Tuetuopay/dalton-evse/README.md

# OSS EVSE

I hope you like the daltons!
