Tuetuopay/dalton-evse/averell4evse/README.md

# averell4evse

The largest PCB housing the input devices (NFC, touch).
