Tuetuopay/dalton-evse/joe4evse/README.md

# joe4evse

Joe, the brain of the operation. Main PCB of Daltons EVSE
