Tuetuopay/dalton-evse/ma4evse/README.md

# ma4evse

KiCAD components symbol, footprints and 3D models for Dalton PCBs
