Tuetuopay/dalton-evse/joe4evse/FIPYPinout.ods

Sheet: Pinout
FIPY Pinout
Pin Name | GPIO Name | Pin Type | Specificity | Function
P0 | GPIO3 | IO | PROG | PROG
P1 | GPIO1 | IO | PROG | PROG
P2 | GPIO0 | IO
P3 | GPIO4 | IO |  | MODBUS SMART METER | UART TX EVSE
P4 | GPIO15 | IO |  | MODBUS SMART METER | UART RX EVSE
(LORA)CLK | GPIO5 | IO |  | CLK Averell
(LORA)MOSI | GPIO27 | IO |  | MOSI Averell
(LORA)MISO | GPIO19 | IO |  | MISO Averell
P8 | GPIO2 | IO |  | nRST NFC
P9 | GPIO12 | IO |  | IRQ NFC
P10 | GPIO13 | IO |  | nRSTOUT NFC
P11 | GPIO22 | IO |  | SS NFC
P12 | GPIO21 | IO | ANT Switch
P13 | GPIO36 | I |  | SS LED
P14 | GPIO37 | I
LTE_WAKE | GPIO38 | I
P16 | GPIO39 | I
LTE_CTS | GPIO35 | I
LTE_RX | GPIO34 | I
LTE_RTS | GPIO23 | IO
LTE_TX | GPIO33 | IO
P21 | GPIO26 | IO
P22 | GPIO25 | IO |  | MOD_EN
P23 | GPIO14 | IO |  | RELAY (Outlet Lock)

Sheet: Revision History
Version | Date | Description
2.1 | 6/13/2013 | Included package ordering code.
2.0 | 3/13/2013 | Updated table format to include all packages
1.0 | 10/1/2012 | Chnaged name from "TQ144" to "144-pin TQFP" Production Release
0.92 | 12/14/2011 | Package drawing, removed option notes 6 and 7
0.91 | 11/13/2011 | 1K pins 40, 49, 50, 52, 133, 134 updated
0.9 | 10/31/2011 | Preliminary
