Tuetuopay/dalton-evse/ma4evse/3d/ASMB-MTB0-0A3A2.step

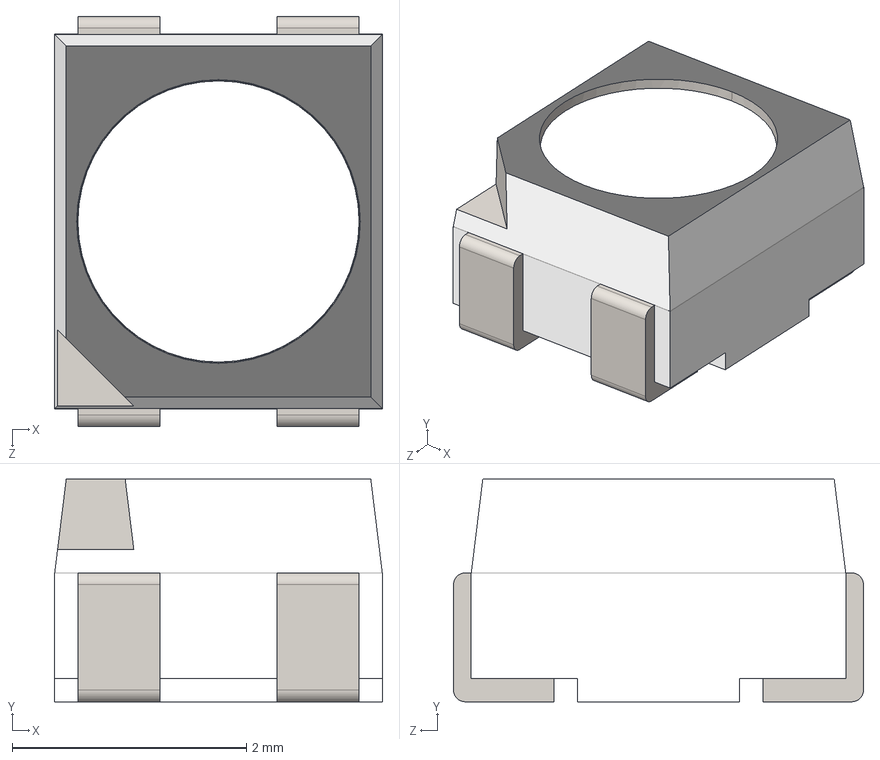
[picture p1: CAD file, 2022-01-18]
ma4evse/3d/ASMB-MTB0-0A3A2.step
2.80 x 1.90 x 3.50 mm
