Tuetuopay/dalton-evse/jack4evse/jack.FCStd

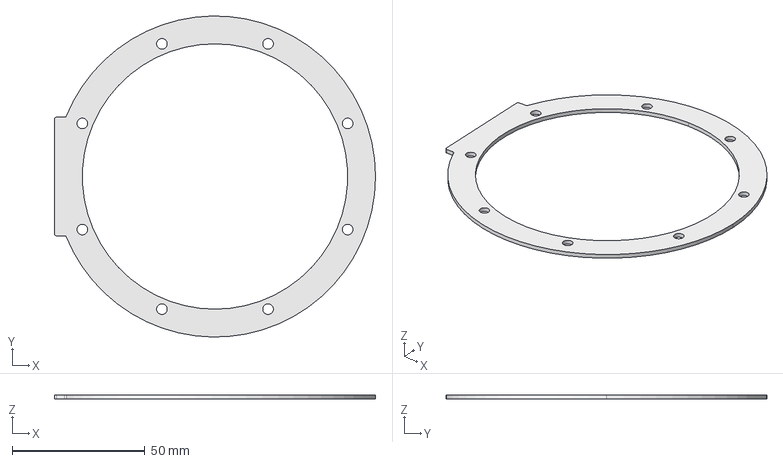
[picture p2: CAD file, 2022-01-18]
jack4evse/jack.FCStd
121.0 x 121.0 x 1.60 mm
