Tuetuopay/dalton-evse/william4evse/RCMB121.FCStd

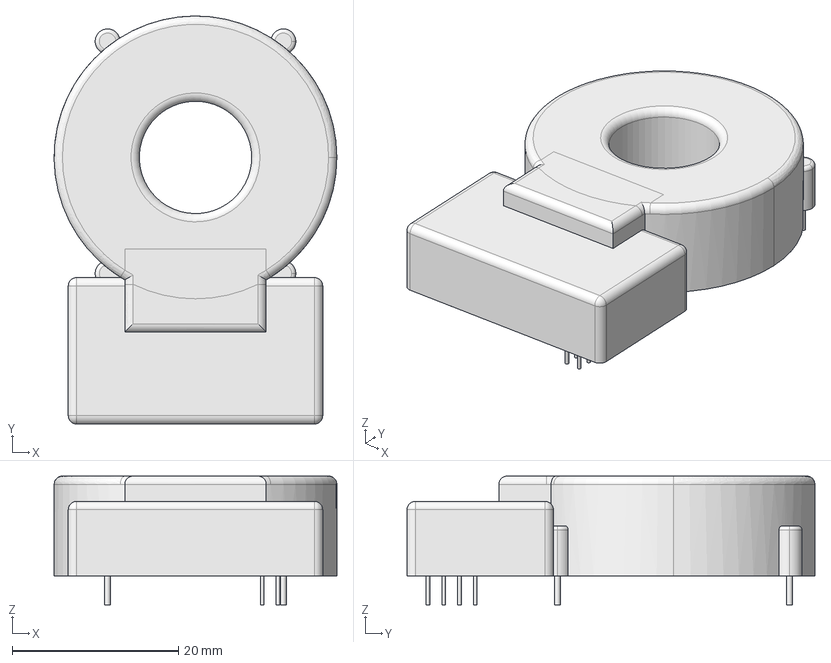
[picture p3: CAD file, 2022-01-18]
william4evse/RCMB121.FCStd
34.0 x 49.0 x 15.5 mm
