Tuetuopay/dalton-evse/ma4evse/3d/Wurth_614105150721.step

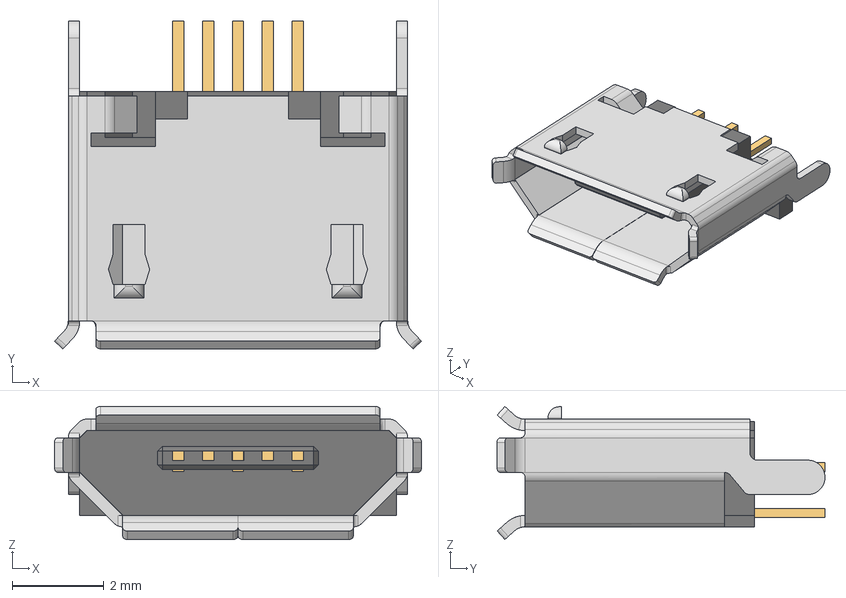
[picture p4: CAD file, 2022-01-18]
ma4evse/3d/Wurth_614105150721.step
8.00 x 7.15 x 2.90 mm
614105150721_Housing
614105150721_Pin1 x 3
614105150721_Pin2 x 2
614105150721_Shielding
