Tuetuopay/dalton-evse/ma4evse/3d/JIS C 6560.step

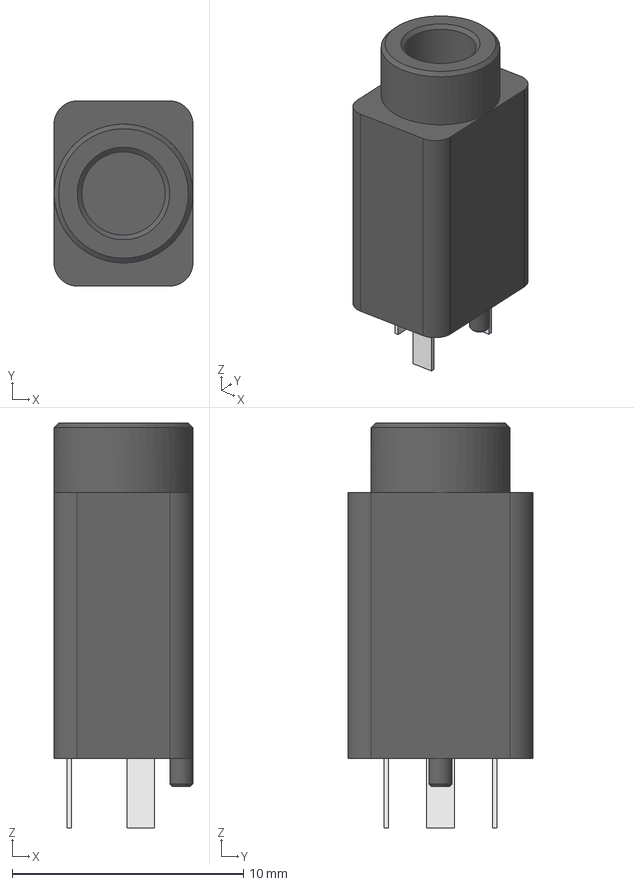
[picture p5: CAD file, 2022-01-18]
ma4evse/3d/JIS C 6560.step
6.00 x 8.00 x 17.5 mm
Pins
