Tuetuopay/dalton-evse/ma4evse/3d/PJ-307C.step

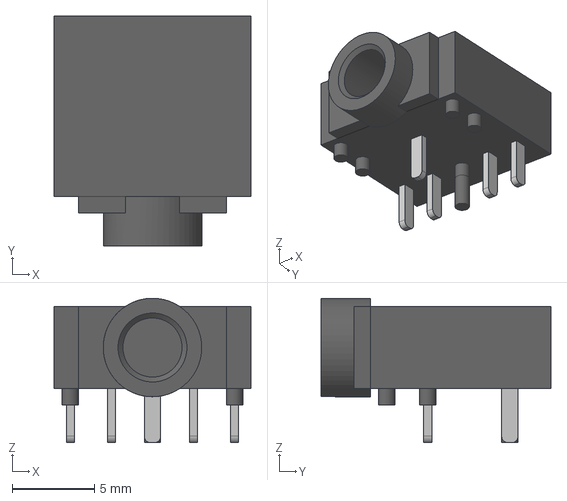
[picture p6: CAD file, 2022-01-18]
ma4evse/3d/PJ-307C.step
12.0 x 14.0 x 8.80 mm
Pins
