Tuetuopay/dalton-evse/ma4evse/3d/HLK-PM0x.step

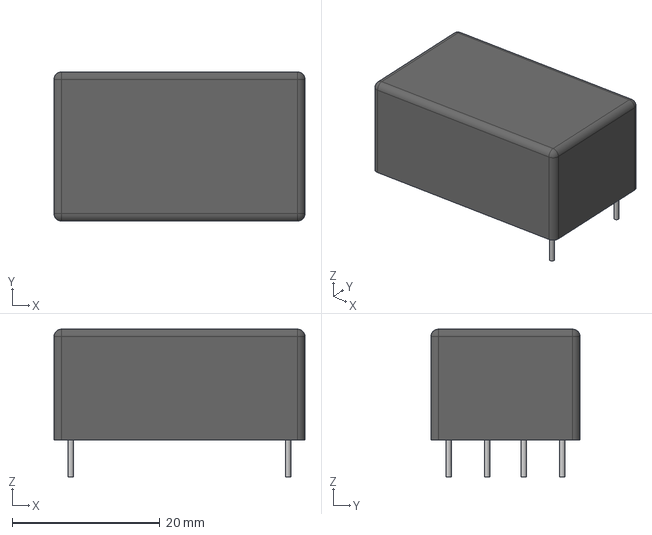
[picture p7: CAD file, 2022-01-18]
ma4evse/3d/HLK-PM0x.step
34.0 x 20.2 x 20.0 mm
Pins
