Tuetuopay/dalton-evse/ma4evse/3d/LoPy v1.stp

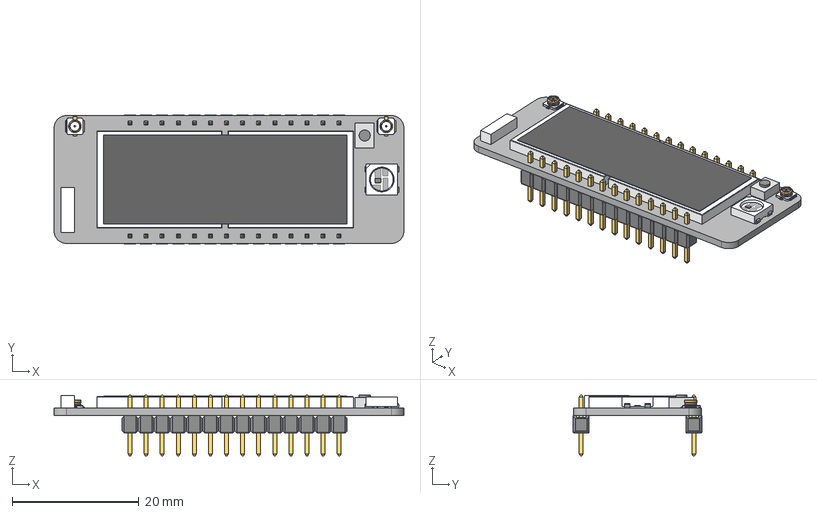
[picture p8: CAD file, 2022-01-18]
ma4evse/3d/LoPy v1.stp
55.2 x 20.3 x 9.60 mm
PCB
Mold x 2
Antenna
Button
ButtonTop
Label
