Tuetuopay/dalton-evse/ma4evse/3d/2520 SMD Crystal Oscillator.STEP

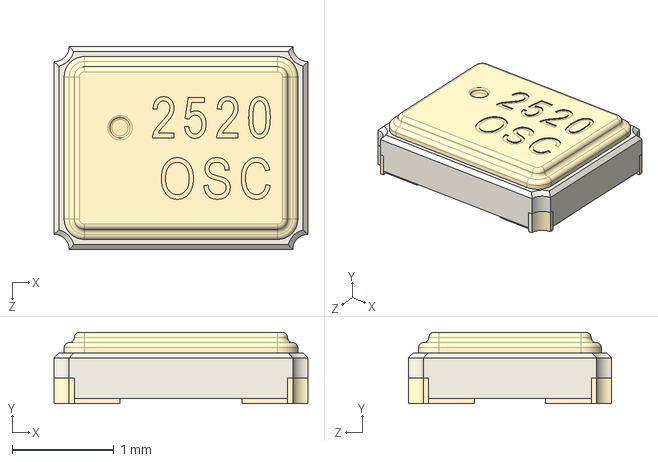
[picture p9: CAD file, 2022-01-18]
ma4evse/3d/2520 SMD Crystal Oscillator.STEP
2.50 x 0.7 x 2.00 mm
