Tuetuopay/dalton-evse/ma4evse/3d/pxc_2896416_01_BC-53-6-OT-U11-KMGY_3D.stp

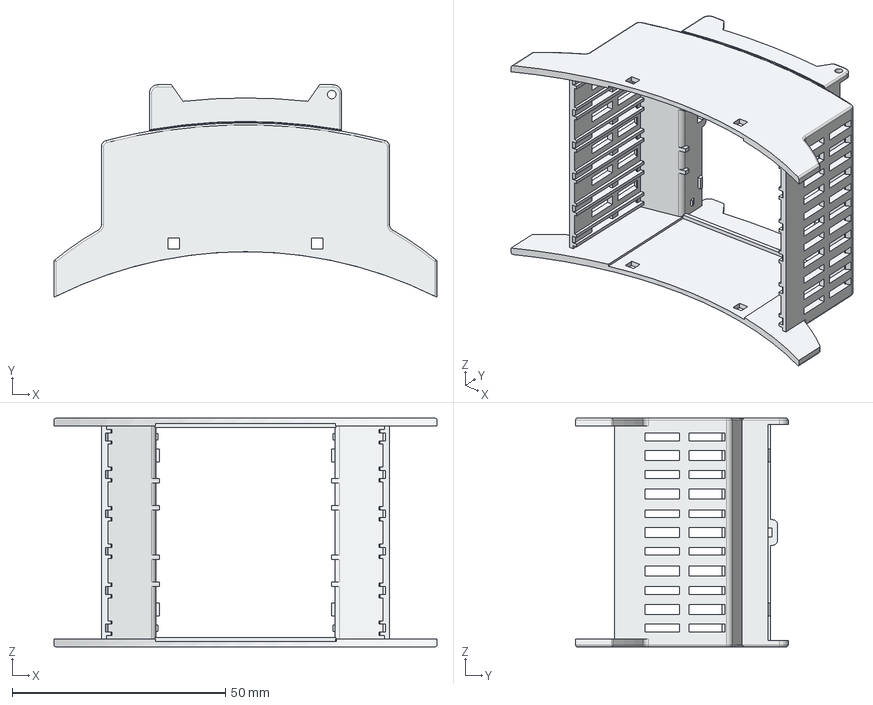
[picture p10: CAD file, 2022-01-18]
ma4evse/3d/pxc_2896416_01_BC-53-6-OT-U11-KMGY_3D.stp
89.7 x 49.8 x 53.6 mm
