Tuetuopay/dalton-evse/ma4evse/3d/pxc_2896403_03_BC-53-6-UT-HBUS-BK_3D.stp

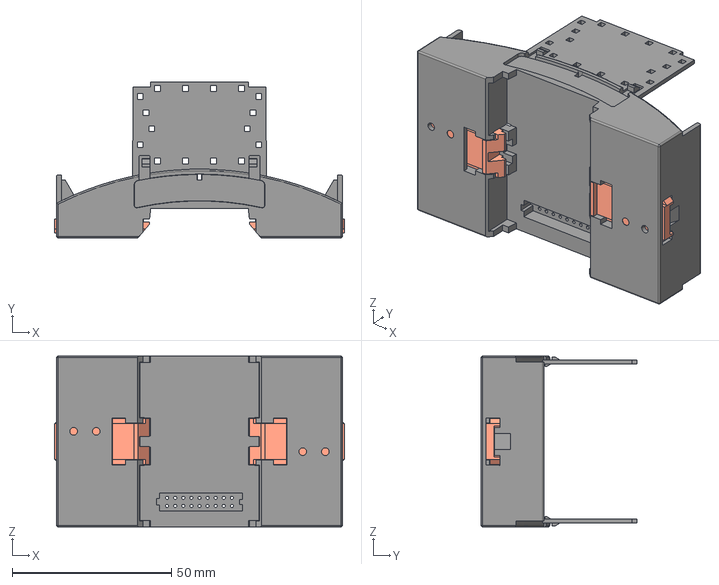
[picture p11: CAD file, 2022-01-18]
ma4evse/3d/pxc_2896403_03_BC-53-6-UT-HBUS-BK_3D.stp
91.0 x 48.9 x 53.6 mm
BC_53_6_GEH-UT_HBUS_H.Select__00383604
Fussriegel_14.4_L30_Sperr_H.Select__00370451 x 2
