Tuetuopay/dalton-evse/ma4evse/3d/FTSH-108-01-F-D-RA.stp

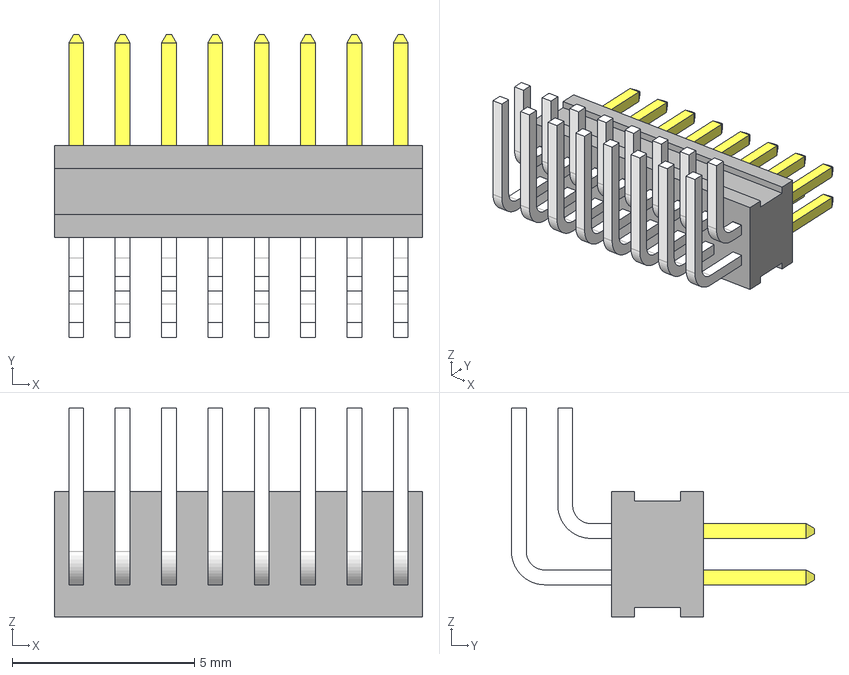
[picture p12: CAD file, 2022-01-18]
ma4evse/3d/FTSH-108-01-F-D-RA.stp
10.1 x 8.31 x 5.72 mm
_FTSH-108-01-F-D-RA_body
_FTSH-108-01-F-D-RA_pins1
_FTSH-108-01-F-D-RA_pins2
