Tuetuopay/dalton-evse/ma4evse/3d/CLP-108-02-F-DH.stp

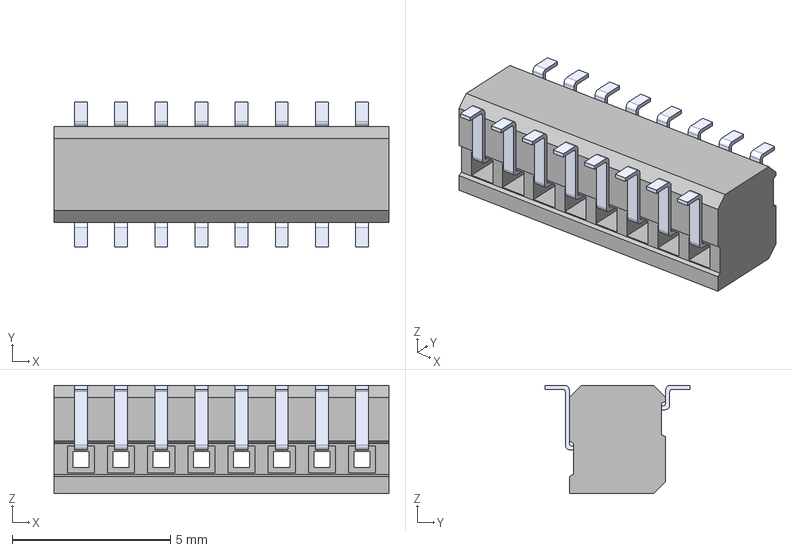
[picture p13: CAD file, 2022-01-18]
ma4evse/3d/CLP-108-02-F-DH.stp
10.6 x 4.57 x 3.43 mm
_CLP-108-2-F-DH_terminal
_C-70-04-108_Pin_2_dh
_C-70-05-108_Pin_dh
