Tuetuopay/dalton-evse/ma4evse/3d/nfc_v4.step

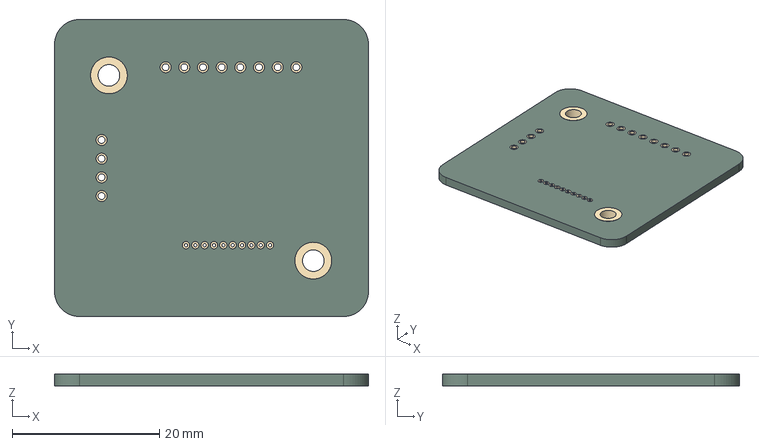
[picture p14: CAD file, 2022-01-18]
ma4evse/3d/nfc_v4.step
42.7 x 40.4 x 1.66 mm
Pcb
Pcb001
