Tuetuopay/dalton-evse/ma4evse/3d/Screw Terminal Block 3.5mm 2-way.step

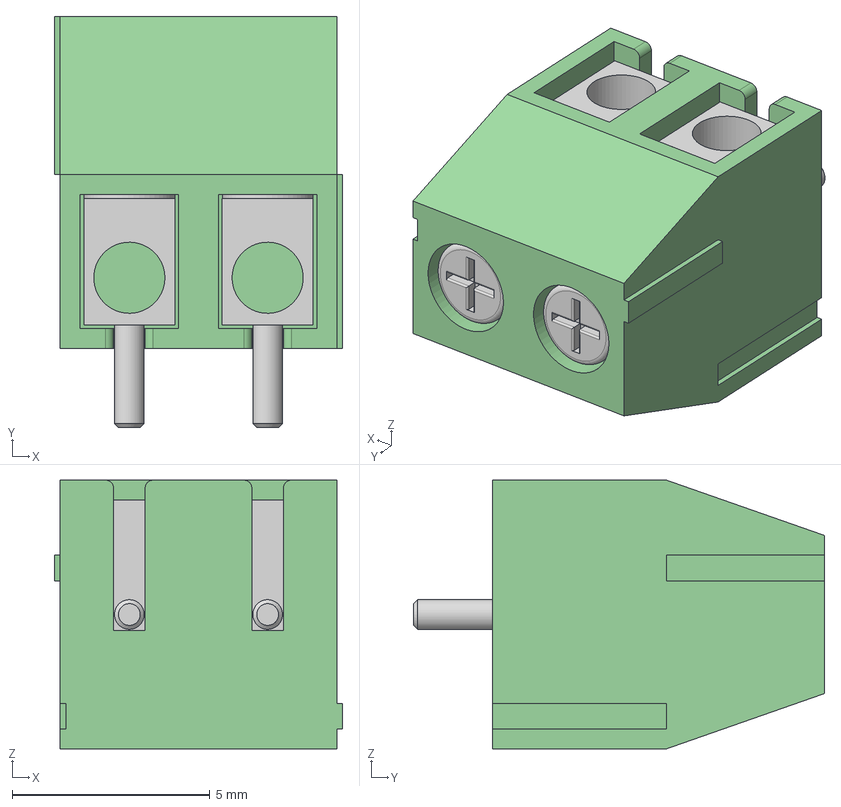
[picture p15: CAD file, 2022-01-18]
ma4evse/3d/Screw Terminal Block 3.5mm 2-way.step
7.30 x 10.4 x 6.80 mm
