Tuetuopay/dalton-evse/ma4evse/3d/ScrewTerminal.STEP

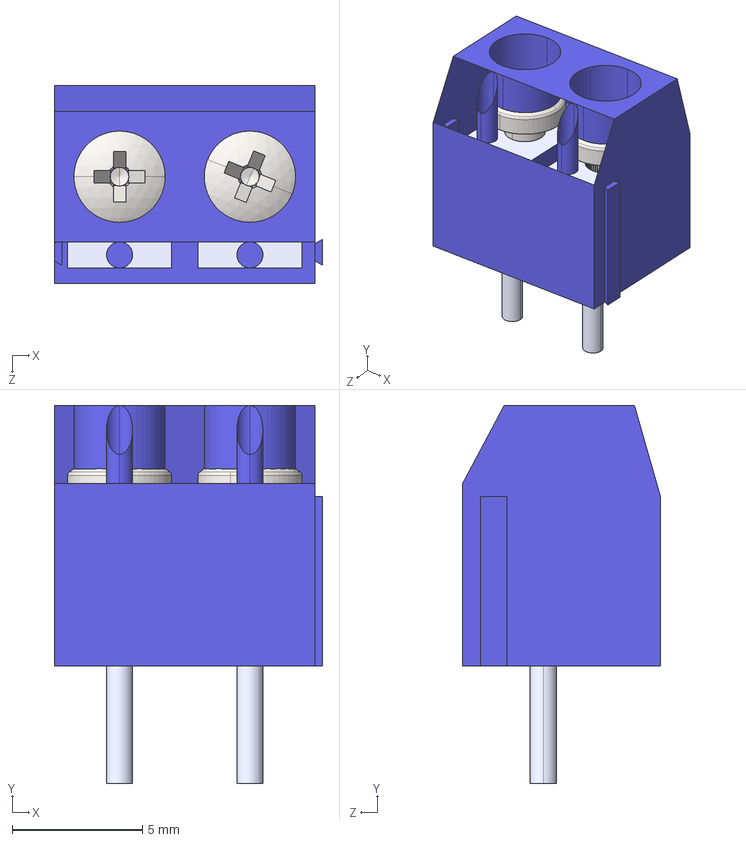
[picture p16: CAD file, 2022-01-18]
ma4evse/3d/ScrewTerminal.STEP
10.3 x 14.5 x 7.60 mm
ScrewTerminalCover
Pin x 2
pan head cross recess screw_iso_ISO 7045 - M2 x 3 - Z - 3N x 2
