Tuetuopay/dalton-evse/ma4evse/3d/JS202011CQN.stp

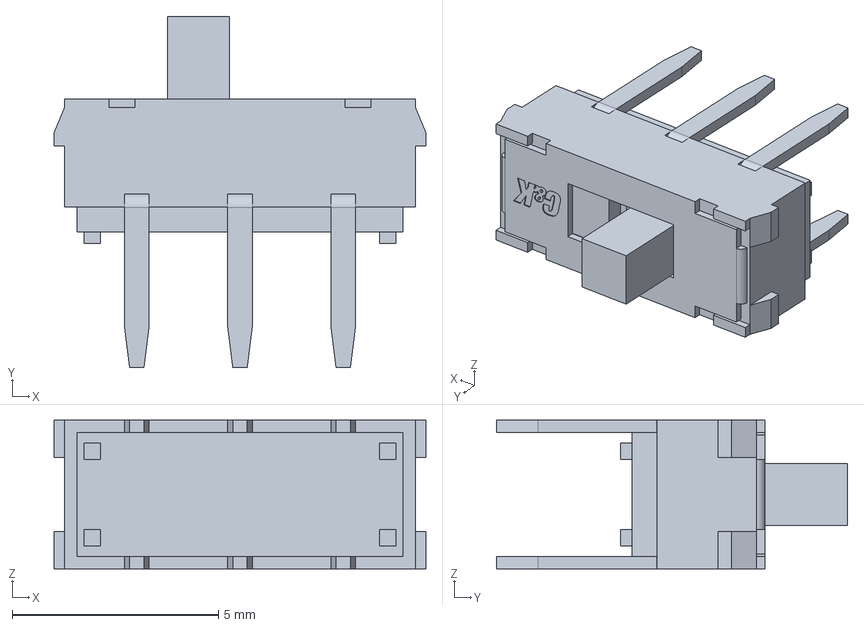
[picture p17: CAD file, 2022-01-18]
ma4evse/3d/JS202011CQN.stp
9.00 x 8.50 x 3.60 mm
