Tuetuopay/dalton-evse/(list of files, cad)

Other CAD files:
ma4evse/3d/RCMB121.step
jack4evse/jack.dxf
ma4evse/3d/HLK-PM0x.FCStd
ma4evse/3d/JIS C 6560.FCStd
ma4evse/3d/PJ-307C.FCStd
ma4evse/3d/nfc_v4.FCStd
william4evse/RCMB121.dxf
