Tuetuopay/dalton-evse/william4evse/william4evse.kicad_pcb

## KiCad design william4evse/william4evse.kicad_pcb (2022-01-18)

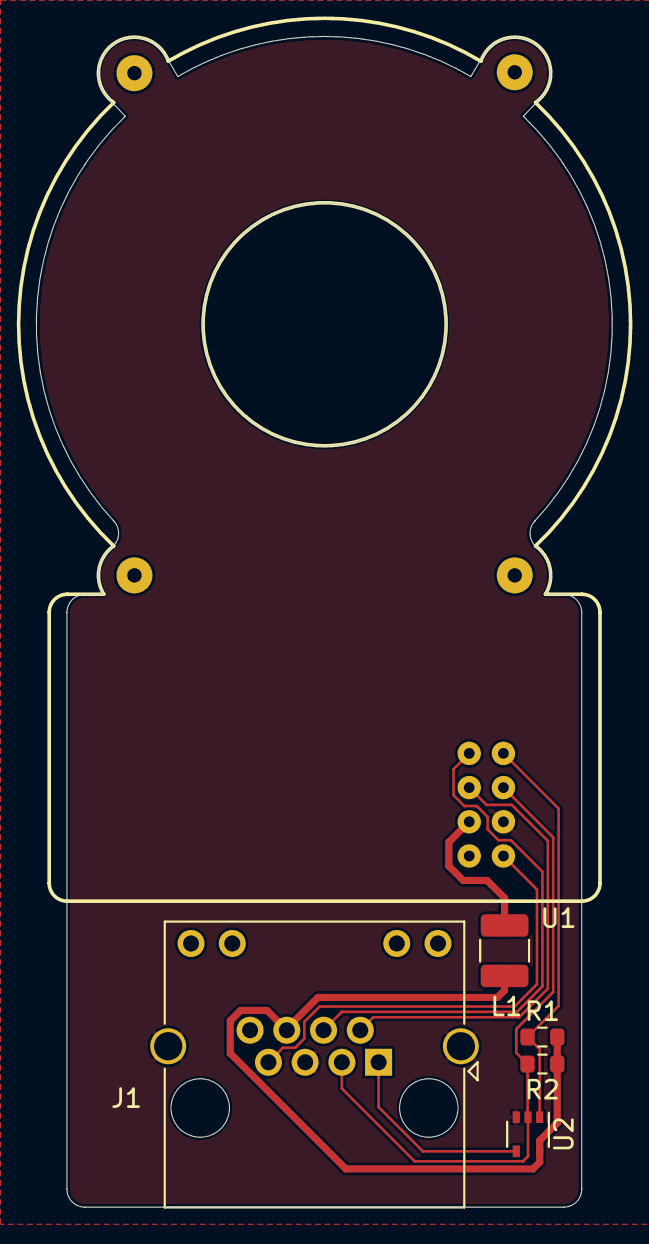
[picture p18: board william4evse.kicad_pcb from above]

Board: 2 copper layers, 32.0 x 65.0 mm, 6 parts (0 on the bottom side), 9 nets.

Parts:
J1: Boom_Precision_RJ45-B-1x1; RJ45_Amphenol_RJHSE538X
L1: 330u; L_1210_3225Metric
R1, R2: 10k; R_0603_1608Metric
U1: RCMB121
U2: 74LVC1G32; SOT-353_SC-70-5

Connections:
+5V: J1.6, L1.1, R1.2, R2.1, U2.5
/ERROR_OUT: R1.1, U1.1, U2.1
/FAULT_OUT: J1.1, U2.4
/PWM_OUT: J1.7, U1.7
/TEST_IN: J1.4, U1.2
/X6_OUT: J1.3, R2.2, U1.3, U2.2
/X30_OUT: J1.2, U1.4
GND: J1.5, J1.SH, U1.5, U2.3
unnamed: L1.2, U1.6
