Tuetuopay/dalton-evse/joe4evse/joe4evse.kicad_pcb

## KiCad design joe4evse/joe4evse.kicad_pcb (2022-01-18)

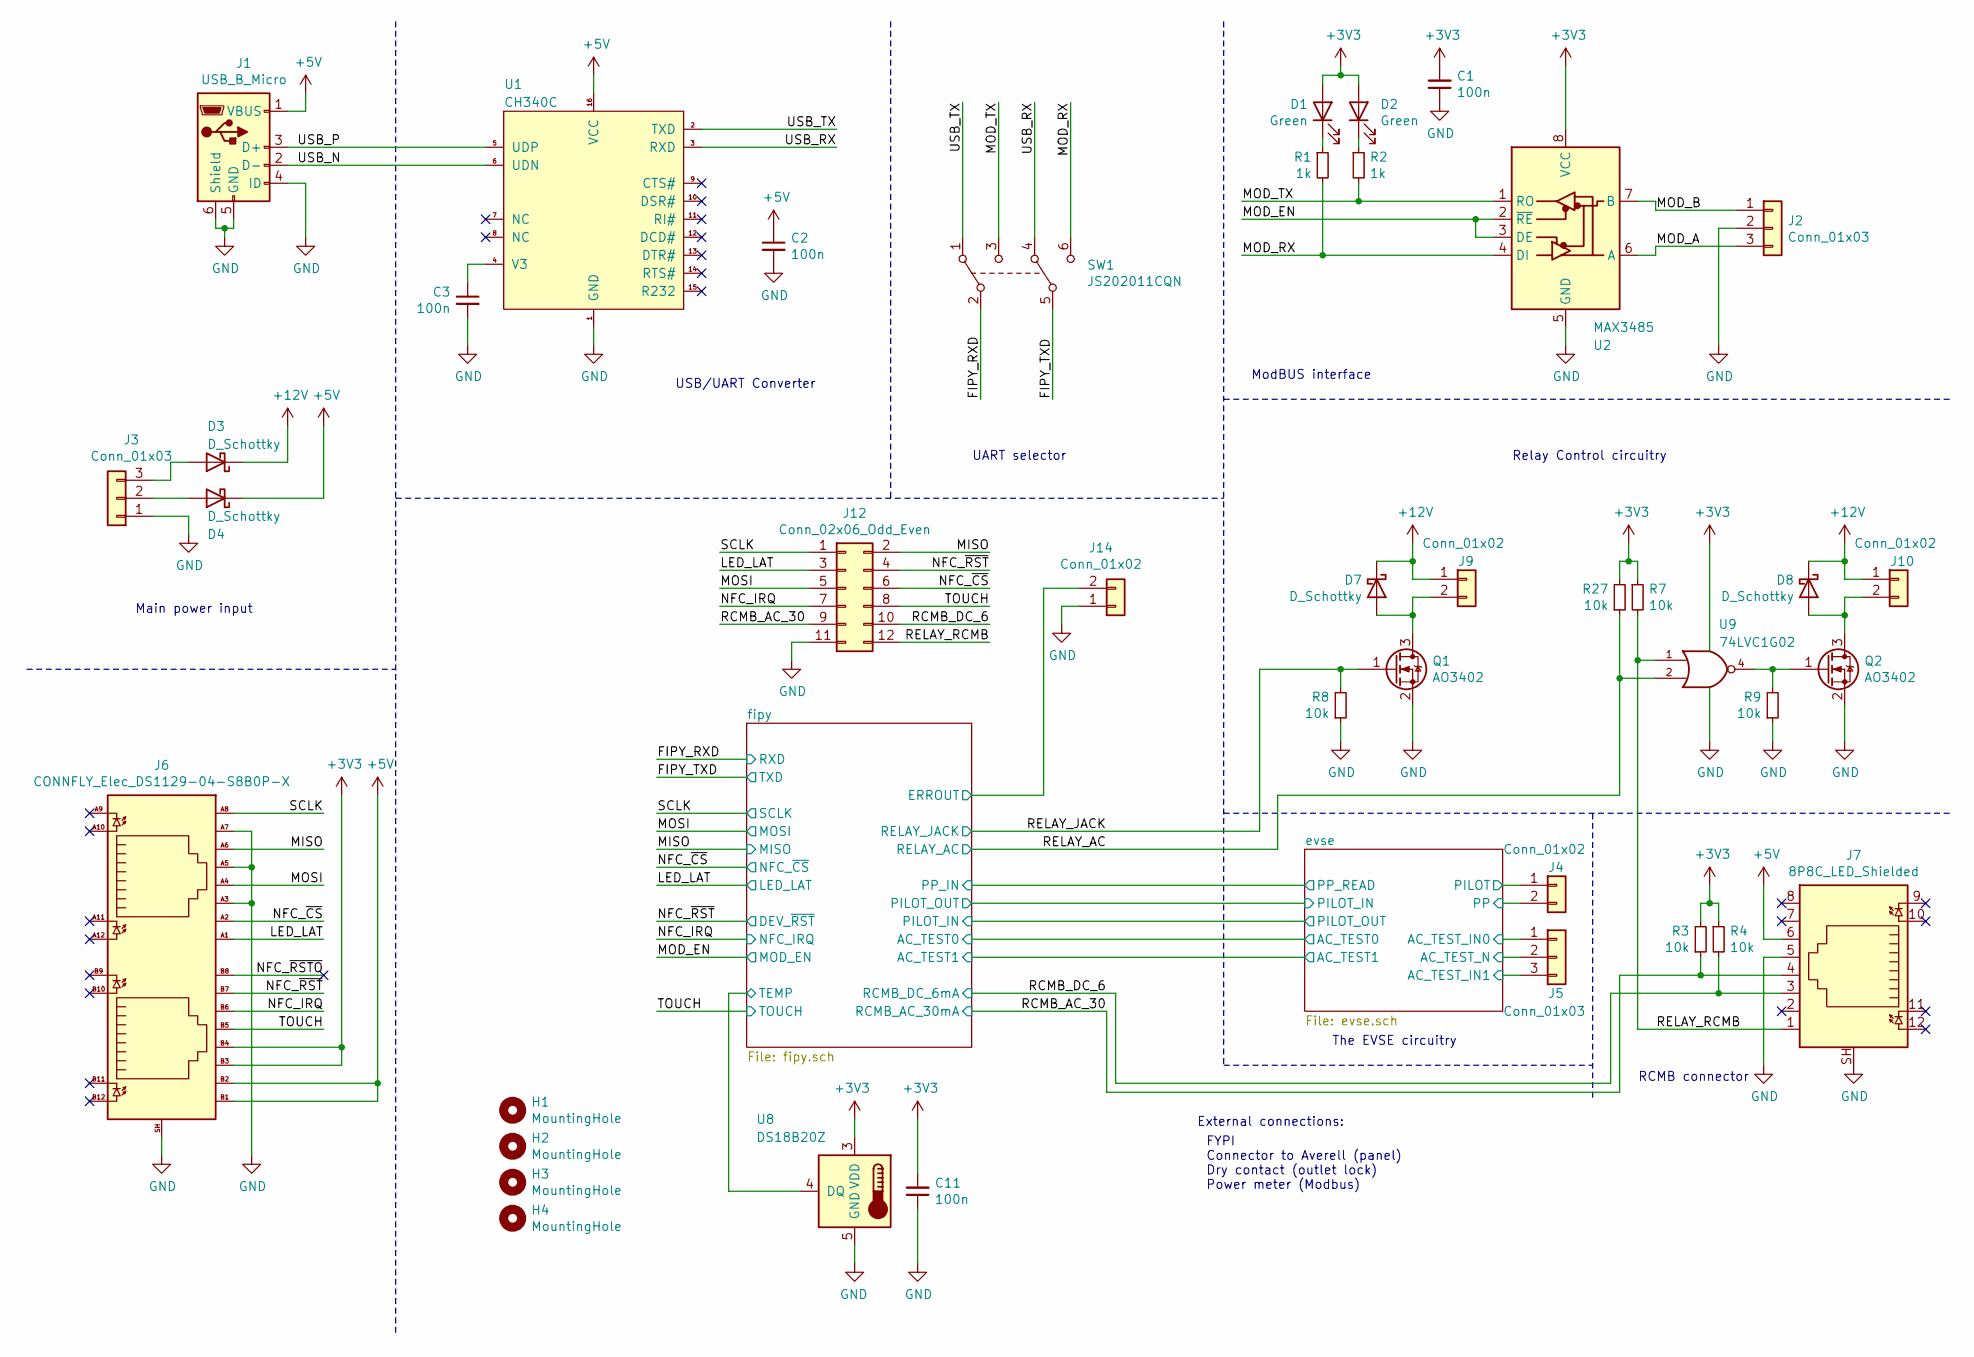
[picture p19: schematic joe4evse.sch, Joe 4 EVSE]

Parts:
C1, C2, C3, C11: 100n; C_0603_1608Metric
D1, D2: Green; LED_0603_1608Metric
D3, D4, D7, D8: D_Schottky; D_SOD-123
H1, H2, H3, H4: MountingHole; MountingHole_3.2mm_M3_Pad_Via
J1: USB_B_Micro; USB_Micro-B_Molex_47346-0001
J2: Conn_01x03; JST_PH_B3B-PH-K_1x03_P2.00mm_Vertical
J3: Conn_01x03; JST_EH_B3B-EH-A_1x03_P2.50mm_Vertical
J4, J9, J10, J14: Conn_01x02; JST_PH_B2B-PH-K_1x02_P2.00mm_Vertical
J5: Conn_01x03; JST_NV_B03P-NV_1x03_P5.00mm_Vertical
J6: CONNFLY_Elec_DS1129-04-S8B0P-X
J7: 8P8C_LED_Shielded; RJ45_Amphenol_RJHSE538X
J12: Conn_02x06_Odd_Even; PinHeader_2x06_P2.54mm_Vertical
Q1, Q2: AO3402; SOT-23
R1, R2: 1k; R_0603_1608Metric
R3, R4, R7, R8, R9, R27: 10k; R_0603_1608Metric
SW1: JS202011CQN
U1: CH340C; SOIC-16_3.9x9.9mm_P1.27mm
U2: MAX3485; SOIC-8_3.9x4.9mm_P1.27mm
U8: DS18B20Z; SOIC-8_3.9x4.9mm_P1.27mm
U9: 74LVC1G02; SOT-353_SC-70-5

Connections:
+3V3: C1.2, C11.2, D1.2 (A), D2.2 (A), J6.B3, J6.B4, R3.2, R4.1, R7.1, R27.2, U2.8 (VCC), U8.3 (VDD), U9.5 (VCC); also elsewhere on the board
+5V: C2.1, D4.1 (K), D4.2 (A), J1.1 (VBUS), J3.2, J6.B1, J6.B2, J7.6, U1.16 (VCC); also elsewhere on the board
+12V: D3.1 (K), D3.2 (A), D7.1 (K), D8.1 (K), J3.3, J9.1, J10.1; also elsewhere on the board
/FIPY_RXD: SW1.2 (B1); also elsewhere on the board
/FIPY_TXD: SW1.5 (B2); also elsewhere on the board
/LED_LAT: J6.A1, J12.3; also elsewhere on the board
/MISO: J6.A6, J12.2; also elsewhere on the board
/MOD_A: J2.3, U2.6 (A)
/MOD_B: J2.1, U2.7 (B)
/MOD_EN: U2.2 (~RE), U2.3 (DE); also elsewhere on the board
/MOD_RX: R1.2, SW1.6 (C2), U2.4 (DI); also elsewhere on the board
/MOD_TX: R2.2, SW1.3 (C1), U2.1 (RO); also elsewhere on the board
/MOSI: J6.A4, J12.5; also elsewhere on the board
/NFC_IRQ: J6.B6, J12.7; also elsewhere on the board
/NFC_~CS: J6.A2, J12.6; also elsewhere on the board
/NFC_~RST: J6.B7, J12.4; also elsewhere on the board
/NFC_~RSTO: J6.B8
/RCMB_AC_30: J7.4, J12.9, R3.1; also elsewhere on the board
/RCMB_DC_6: J7.3, J12.10, R4.2; also elsewhere on the board
/RELAY_AC: R27.1, U9.2; also elsewhere on the board
/RELAY_JACK: Q1.1 (G), R8.2; also elsewhere on the board
/RELAY_RCMB: J7.1, J12.12, R7.2, U9.1
/SCLK: J6.A8, J12.1; also elsewhere on the board
/TOUCH: J6.B5, J12.8; also elsewhere on the board
/USB_N: J1.2 (D-), U1.6 (UDN)
/USB_P: J1.3 (D+), U1.5 (UDP)
/USB_RX: SW1.4 (A2), U1.3 (RXD)
/USB_TX: SW1.1 (A1), U1.2 (TXD)
/evse/AC_TEST_IN0: J5.1; also elsewhere on the board
/evse/AC_TEST_IN1: J5.3; also elsewhere on the board
/evse/AC_TEST_N: J5.2; also elsewhere on the board
/evse/PILOT: J4.1; also elsewhere on the board
/evse/PP: J4.2; also elsewhere on the board
/fipy/ERROUT: J14.2; also elsewhere on the board
/fipy/TEMP: U8.4 (DQ); also elsewhere on the board
GND: C1.1, C2.2, C3.2, C11.1, J1.4 (ID), J1.5 (GND), J1.6 (Shield), J2.2, J3.1, J6.A3, J6.A5, J6.A7, J6.SH, J7.5, J7.SH, J12.11, J14.1, Q1.2 (S), Q2.2 (S), R8.1, R9.1, U1.1 (GND), U2.5 (GND), U8.5 (GND), U9.3 (GND); also elsewhere on the board
unnamed: C3.1, U1.4 (V3)
unnamed: D1.1 (K), R1.1
unnamed: D2.1 (K), R2.1
unnamed: D7.2 (A), J9.2, Q1.3 (D)
unnamed: D8.2 (A), J10.2, Q2.3 (D)
unnamed: Q2.1 (G), R9.2, U9.4

Notes on the sheet:
Main power input
USB/UART Converter
UART selector
ModBUS interface
External connections:
FYPI Connector to Averell (panel) Dry contact (outlet lock) Power meter (Modbus)
RCMB connector
The EVSE circuitry
Relay Control circuitry

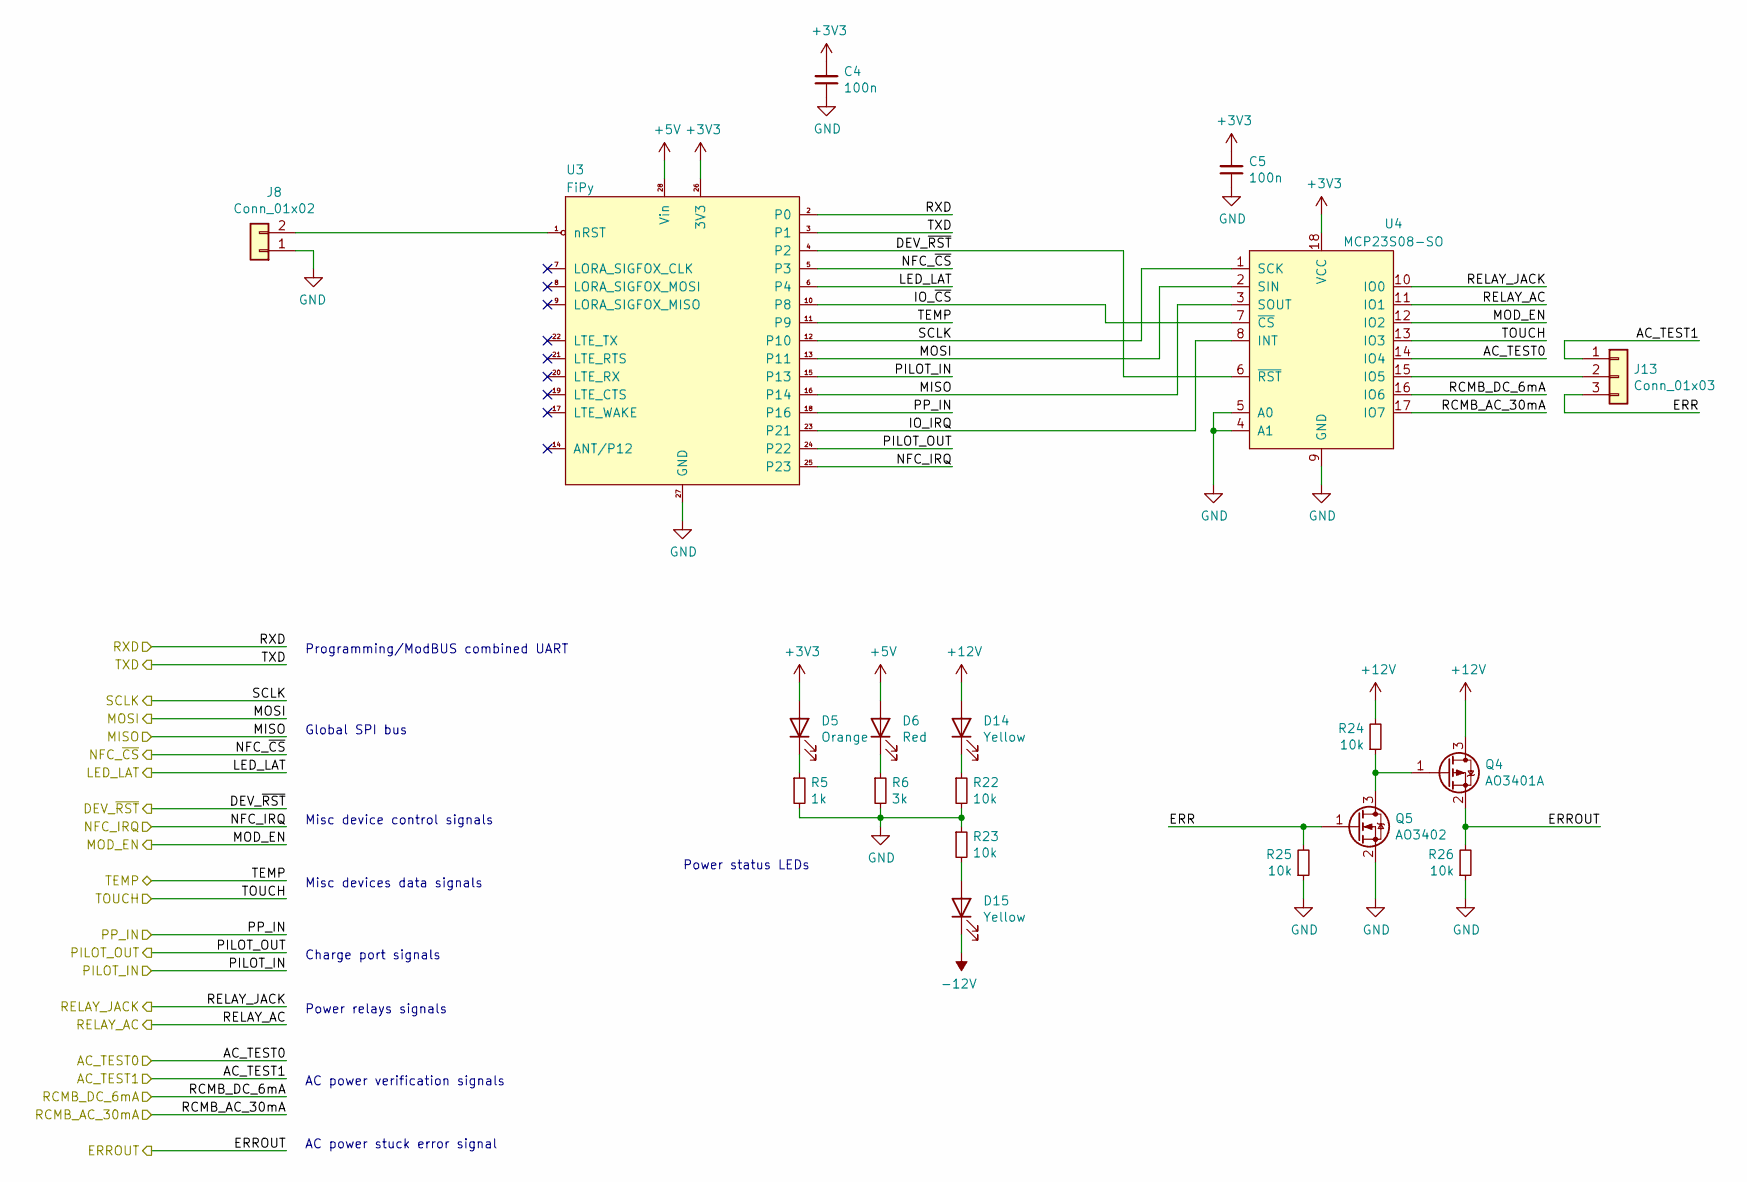
[picture p20: schematic fipy.sch, Joe 4 EVSE]

Parts:
C4, C5: 100n; C_0603_1608Metric
D5: Orange; LED_0603_1608Metric
D6: Red; LED_0603_1608Metric
D14, D15: Yellow; LED_0603_1608Metric
J8: Conn_01x02; PinHeader_1x02_P2.54mm_Vertical
J13: Conn_01x03; PinHeader_1x03_P2.54mm_Vertical
Q4: AO3401A; SOT-23
Q5: AO3402; SOT-23
R5: 1k; R_0603_1608Metric
R6: 3k; R_0603_1608Metric
R22, R23, R24, R25, R26: 10k; R_0603_1608Metric
U3: FiPy; fipy
U4: MCP23S08-SO; SOIC-18W_7.5x11.6mm_P1.27mm

Connections:
+3V3: C4.2, C5.2, D5.2 (A), U3.26 (3V3), U4.18 (VCC); also elsewhere on the board
+5V: D6.2 (A), U3.28 (Vin); also elsewhere on the board
+12V: D14.2 (A), Q4.3 (D), R24.2; also elsewhere on the board
-12V: D15.1 (K); also elsewhere on the board
/FIPY_RXD: U3.2 (P0); also elsewhere on the board
/FIPY_TXD: U3.3 (P1); also elsewhere on the board
/LED_LAT: U3.6 (P4); also elsewhere on the board
/MISO: U3.16 (P14), U4.3 (SOUT); also elsewhere on the board
/MOD_EN: U4.12 (IO2); also elsewhere on the board
/MOSI: U3.13 (P11), U4.2 (SIN); also elsewhere on the board
/NFC_IRQ: U3.25 (P23); also elsewhere on the board
/NFC_~CS: U3.5 (P3); also elsewhere on the board
/NFC_~RST: U3.4 (P2), U4.6 (~RST); also elsewhere on the board
/RCMB_AC_30: U4.17 (IO7); also elsewhere on the board
/RCMB_DC_6: U4.16 (IO6); also elsewhere on the board
/RELAY_AC: U4.11 (IO1); also elsewhere on the board
/RELAY_JACK: U4.10 (IO0); also elsewhere on the board
/SCLK: U3.12 (P10), U4.1 (SCK); also elsewhere on the board
/TOUCH: U4.13 (IO3); also elsewhere on the board
/evse/AC_TEST0: U4.14 (IO4); also elsewhere on the board
/evse/AC_TEST1: J13.1; also elsewhere on the board
/evse/PILOT_IN: U3.24 (P22); also elsewhere on the board
/fipy/ERR: J13.3, Q5.1 (G), R25.2
/fipy/ERROUT: Q4.2 (S), R26.2; also elsewhere on the board
/fipy/IO_IRQ: U3.23 (P21), U4.8 (INT)
/fipy/IO_~CS: U3.10 (P8), U4.7 (~CS)
/fipy/PILOT_IN: U3.15 (P13); also elsewhere on the board
/fipy/PP_IN: U3.18 (P16); also elsewhere on the board
/fipy/TEMP: U3.11 (P9); also elsewhere on the board
GND: C4.1, C5.1, J8.1, Q5.2 (S), R5.2, R6.2, R22.2, R23.1, R25.1, R26.1, U3.27 (GND), U4.4 (A1), U4.5 (A0), U4.9 (GND); also elsewhere on the board
unnamed: D5.1 (K), R5.1
unnamed: D6.1 (K), R6.1
unnamed: D14.1 (K), R22.1
unnamed: D15.2 (A), R23.2
unnamed: J8.2, U3.1 (nRST)
unnamed: J13.2, U4.15 (IO5)
unnamed: Q4.1 (G), Q5.3 (D), R24.1

Notes on the sheet:
Programming/ModBUS combined UART
Global SPI bus
Misc device control signals
Misc devices data signals
Charge port signals
Power relays signals
AC power verification signals
Power status LEDs
AC power stuck error signal

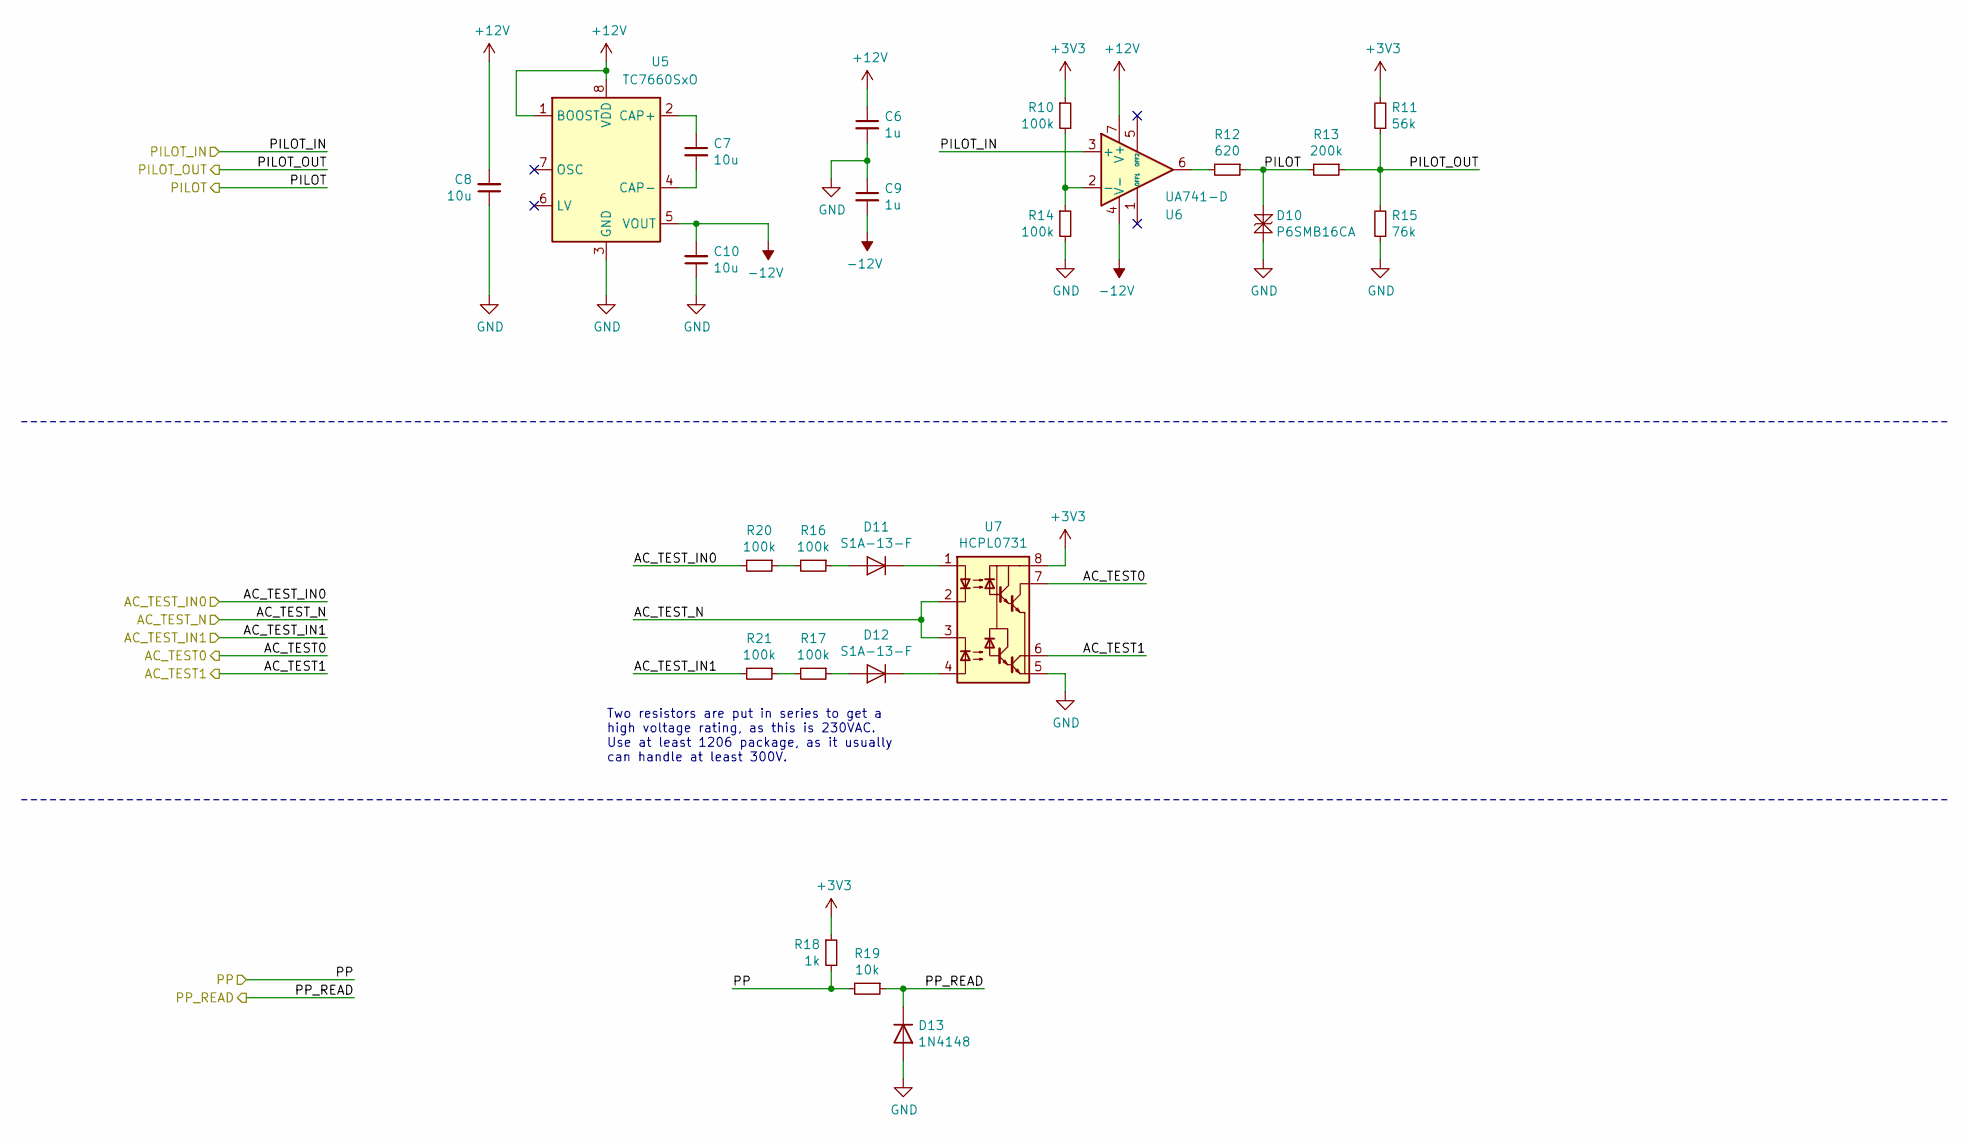
[picture p21: schematic evse.sch, Joe 4 EVSE]

Parts:
C6, C9: 1u; C_0603_1608Metric
C7, C8, C10: 10u; C_0805_2012Metric
D10: P6SMB16CA; D_SMB
D11, D12: S1A-13-F; D_SMA
D13: 1N4148; D_SOD-123
R10, R14: 100k; R_0603_1608Metric
R11: 56k; R_0603_1608Metric
R12: 620; R_0603_1608Metric
R13: 200k; R_0603_1608Metric
R15: 76k; R_0603_1608Metric
R16, R17, R20, R21: 100k; R_1206_3216Metric
R18: 1k; R_0603_1608Metric
R19: 10k; R_0603_1608Metric
U5: TC7660SxO; SOIC-8_3.9x4.9mm_P1.27mm
U6: UA741-D; SOIC-8_3.9x4.9mm_P1.27mm; Manufacturer PN uA741-D
U7: HCPL0731; SOIC-8_3.9x4.9mm_P1.27mm; Manufacturer PN HCPL0731

Connections:
+3V3: R10.1, R11.2, R18.1, U7.8 (VCC); also elsewhere on the board
+12V: C6.1, C8.2, U5.1 (BOOST), U5.8 (VDD), U6.7 (V+); also elsewhere on the board
-12V: C9.2, C10.2, U5.5 (VOUT), U6.4 (V-); also elsewhere on the board
/evse/AC_TEST0: U7.7 (VO1); also elsewhere on the board
/evse/AC_TEST1: U7.6 (VO2); also elsewhere on the board
/evse/AC_TEST_IN0: R20.2; also elsewhere on the board
/evse/AC_TEST_IN1: R21.2; also elsewhere on the board
/evse/AC_TEST_N: U7.2 (C1), U7.3 (C2); also elsewhere on the board
/evse/PILOT: D10.1 (K), R12.1, R13.2; also elsewhere on the board
/evse/PILOT_IN: U6.3 (+); also elsewhere on the board
/evse/PP: R18.2, R19.2; also elsewhere on the board
/fipy/PILOT_IN: R11.1, R13.1, R15.2; also elsewhere on the board
/fipy/PP_IN: D13.1 (K), R19.1; also elsewhere on the board
GND: C6.2, C8.1, C9.1, C10.1, D10.2 (A), D13.2 (A), R14.2, R15.1, U5.3 (GND), U7.5 (GND); also elsewhere on the board
unnamed: C7.1, U5.2 (CAP+)
unnamed: C7.2, U5.4 (CAP-)
unnamed: D11.1 (K), U7.1 (A1)
unnamed: D11.2 (A), R16.1
unnamed: D12.1 (K), U7.4 (A2)
unnamed: D12.2 (A), R17.1
unnamed: R10.2, R14.1, U6.2 (-)
unnamed: R12.2, U6.6
unnamed: R16.2, R20.1
unnamed: R17.2, R21.1

Notes on the sheet:
Two resistors are put in series to get a high voltage rating, as this is 230VAC. Use at least 1206 package, as it usually can handle at least 300V.

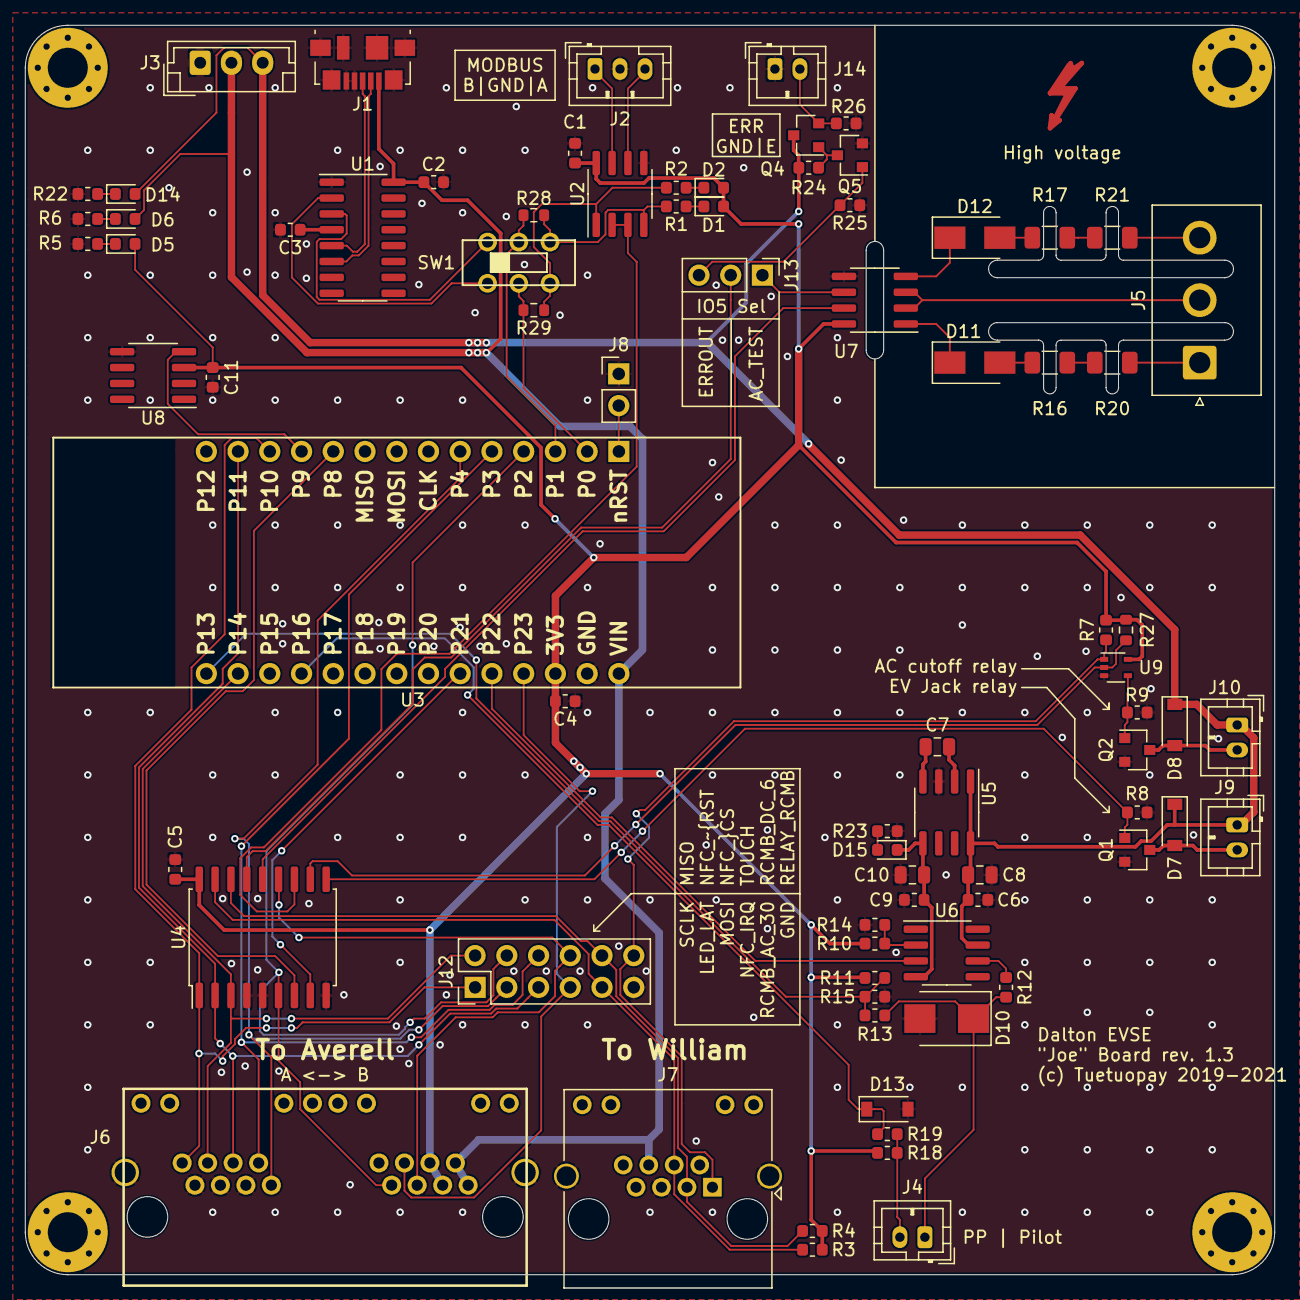
[picture p22: board joe4evse.kicad_pcb from above]

Board: 2 copper layers, 100.0 x 100.0 mm, 83 parts (0 on the bottom side), 67 nets.

Other parts of the board:
R28, R29: 0; R_0603_1608Metric

Their connections:
/FIPY_RXD: R29.2; also elsewhere on the board
/FIPY_TXD: R28.2; also elsewhere on the board
/MOD_RX: R28.1; also elsewhere on the board
/MOD_TX: R29.1; also elsewhere on the board
