Tuetuopay/dalton-evse/jack4evse/jack4evse.kicad_pcb

## KiCad design jack4evse/jack4evse.kicad_pcb (2022-01-18)

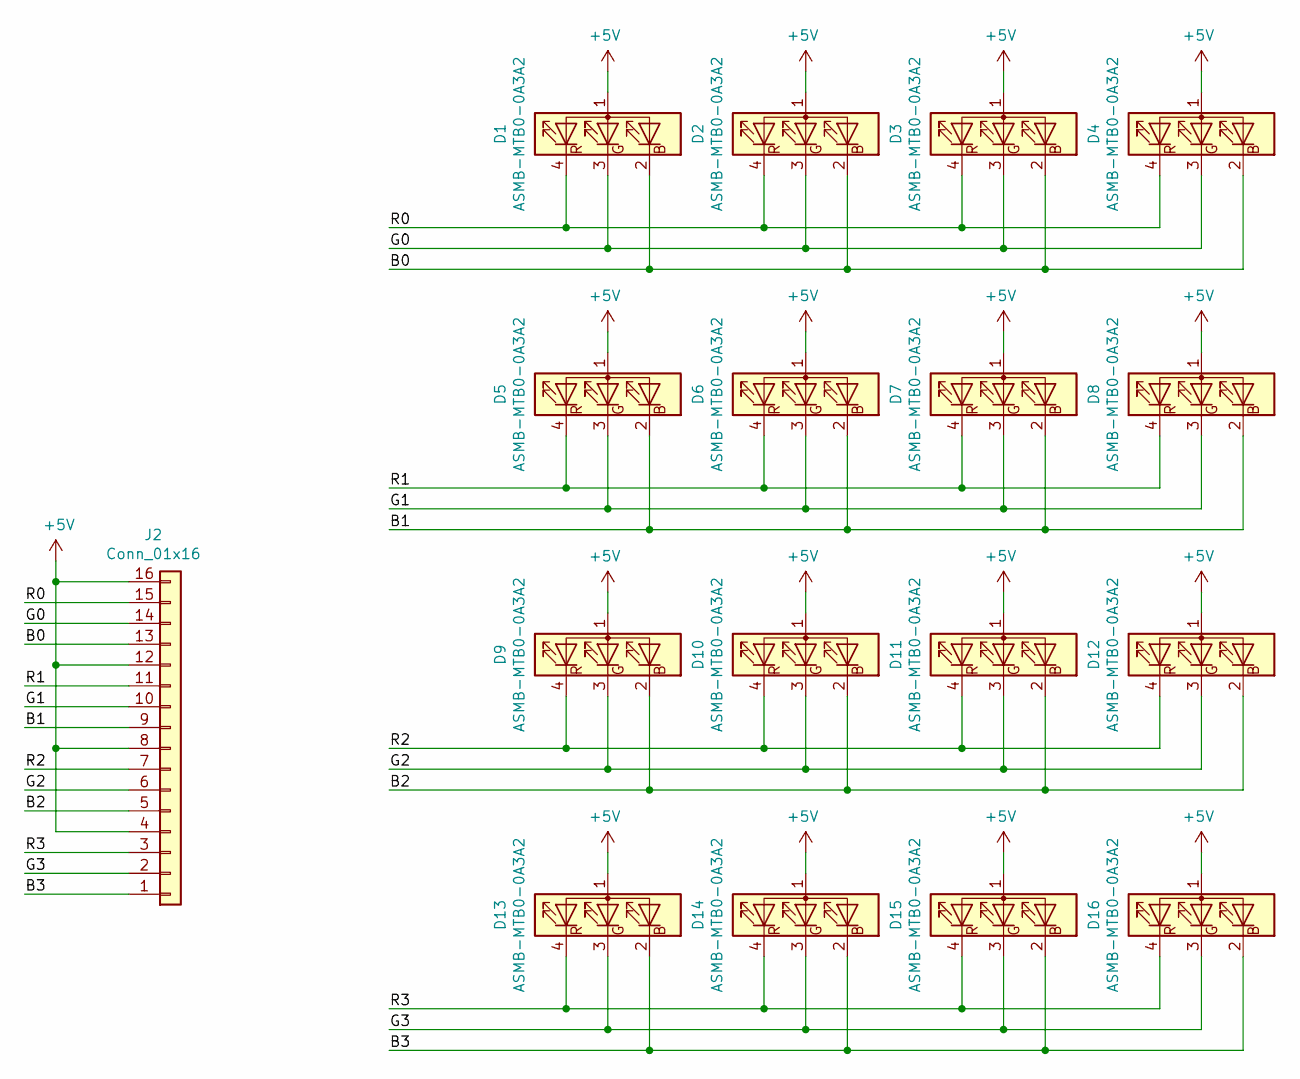
[picture p23: schematic jack4evse.sch]

Parts:
D1, D2, D3, D4, D5, D6, D7, D8, D9, D10, D11, D12, D13, D14, D15, D16: ASMB-MTB0-0A3A2; LED_Avago_PLCC4_3.2x2.8mm_CW
J2: Conn_01x16; PinHeader_1x16_P2.54mm_Horizontal

Connections:
+5V: D1.1 (A), D2.1 (A), D3.1 (A), D4.1 (A), D5.1 (A), D6.1 (A), D7.1 (A), D8.1 (A), D9.1 (A), D10.1 (A), D11.1 (A), D12.1 (A), D13.1 (A), D14.1 (A), D15.1 (A), D16.1 (A), J2.4, J2.8, J2.12, J2.16
/B0: D1.2 (BK), D2.2 (BK), D3.2 (BK), D4.2 (BK), J2.13
/B1: D5.2 (BK), D6.2 (BK), D7.2 (BK), D8.2 (BK), J2.9
/B2: D9.2 (BK), D10.2 (BK), D11.2 (BK), D12.2 (BK), J2.5
/B3: D13.2 (BK), D14.2 (BK), D15.2 (BK), D16.2 (BK), J2.1
/G0: D1.3 (GK), D2.3 (GK), D3.3 (GK), D4.3 (GK), J2.14
/G1: D5.3 (GK), D6.3 (GK), D7.3 (GK), D8.3 (GK), J2.10
/G2: D9.3 (GK), D10.3 (GK), D11.3 (GK), D12.3 (GK), J2.6
/G3: D13.3 (GK), D14.3 (GK), D15.3 (GK), D16.3 (GK), J2.2
/R0: D1.4 (RK), D2.4 (RK), D3.4 (RK), D4.4 (RK), J2.15
/R1: D5.4 (RK), D6.4 (RK), D7.4 (RK), D8.4 (RK), J2.11
/R2: D9.4 (RK), D10.4 (RK), D11.4 (RK), D12.4 (RK), J2.7
/R3: D13.4 (RK), D14.4 (RK), D15.4 (RK), D16.4 (RK), J2.3

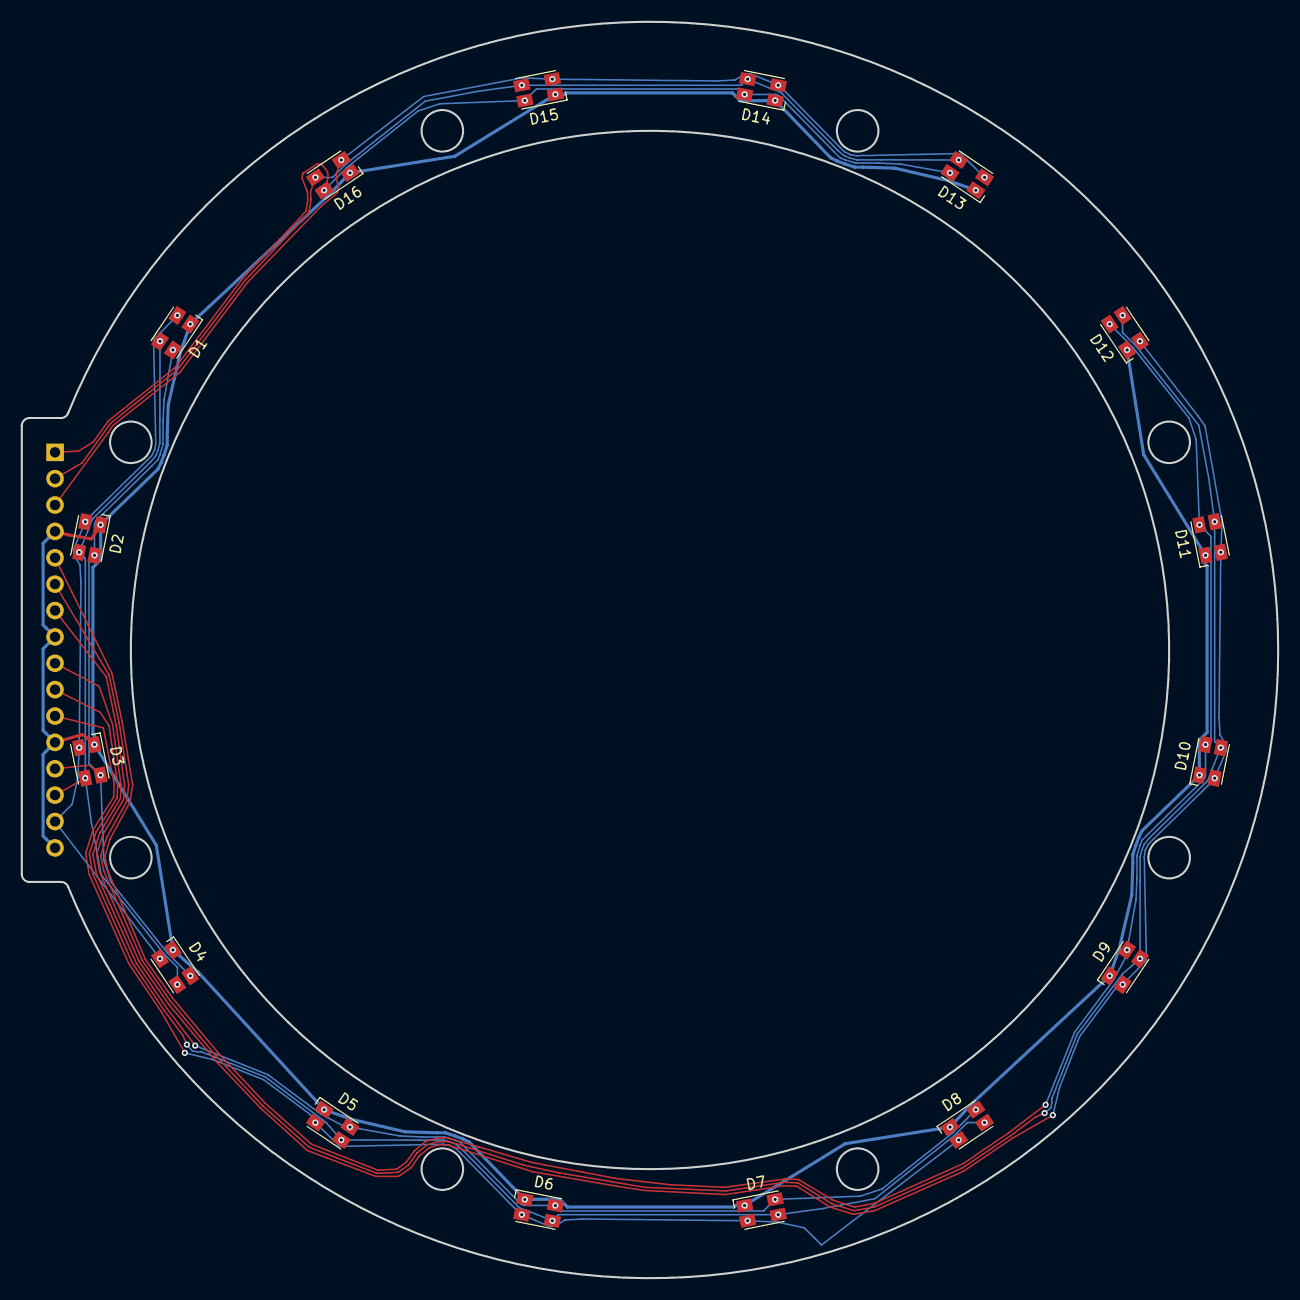
[picture p24: board jack4evse.kicad_pcb from above]

Board: 2 copper layers, 121.0 x 121.0 mm, 17 parts (1 on the bottom side), 13 nets.
