Tuetuopay/dalton-evse/billy4evse/billy4evse.kicad_pcb

## KiCad design billy4evse/billy4evse.kicad_pcb (2022-01-18)

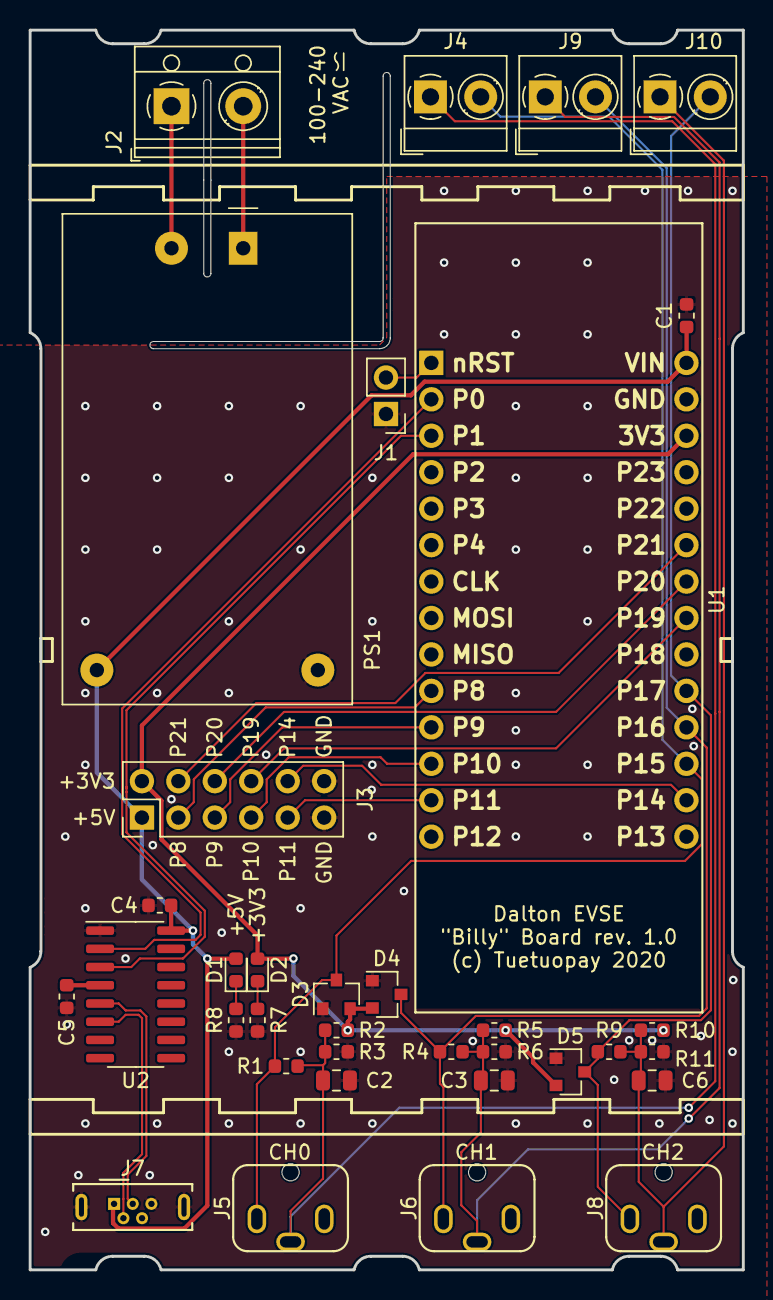
[picture p25: board billy4evse.kicad_pcb from above]

Board: 2 copper layers, 49.7 x 86.4 mm, 35 parts (0 on the bottom side), 27 nets.

Parts:
C1, C4, C5: 100n; C_0603_1608Metric
C2, C3, C6: 10u; C_0805_2012Metric
D1: Red; LED_0603_1608Metric
D2: Orange; LED_0603_1608Metric
D3, D4, D5: BAT54S; SOT-23
J1: Conn_01x02; PinHeader_1x02_P2.54mm_Vertical
J2: Screw_Terminal_01x02; TerminalBlock_RND_205-00012_1x02_P5.00mm_Horizontal
J3: Conn_02x06_Odd_Even; PinHeader_2x06_P2.54mm_Vertical
J4, J9, J10: Screw_Terminal_01x02; TerminalBlock_MetzConnect_Type059_RT06302HBWC_1x02_P3.50mm_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
J5, J6, J8: AudioJack3; JIS-C-6560
J7: USB_B_Micro; USB_Micro-B_Wuerth_614105150721_Vertical
PS1: HLK-PM01; Converter_ACDC_HiLink_HLK-PMxx
R1, R4, R9: 23; R_0603_1608Metric
R2, R3, R5, R6, R10, R11: 10k; R_0603_1608Metric
R7: 3k; R_0603_1608Metric
R8: 1k; R_0603_1608Metric
U1: LoPy; fipy
U2: CH340C; SOIC-16_3.9x9.9mm_P1.27mm

Connections:
+3V3: D2.2, D3.2, D4.2, D5.2, J3.2, R2.2, R5.2, R10.2, U1.26
+5V: C1.2, C4.2, D1.2, J3.1, J7.1, PS1.4, U1.28, U2.16
/AC_L: J2.2, PS1.1
/AC_N: J2.1, PS1.2
/CT0: D3.3, J4.2, J5.S, R1.2, U1.17
/CT1: D4.3, J6.S, J9.2, R4.2, U1.18
/CT2: D5.3, J8.S, J10.2, R9.2, U1.19
/LOPY2USB: U1.3, U2.3
/P8: J3.3, U1.10
/P9: J3.5, U1.11
/P10: J3.7, U1.12
/P11: J3.9, U1.13
/P14: J3.10, U1.16
/P19: J3.8, U1.21
/P20: J3.6, U1.22
/P21: J3.4, U1.23
/USB2LOPY: U1.2, U2.2
/USB_N: J7.2, U2.6
/USB_P: J7.3, U2.5
GND: C1.1, C2.1, C3.1, C4.1, C5.1, C6.1, D3.1, D4.1, D5.1, J1.1, J3.11, J3.12, J7.5, J7.6, PS1.3, R3.1, R6.1, R7.2, R8.2, R11.1, U1.27, U2.1
unnamed: C2.2, J4.1, J5.T, R1.1, R2.1, R3.2
unnamed: C3.2, J6.T, J9.1, R4.1, R5.1, R6.2
unnamed: C5.2, U2.4
unnamed: C6.2, J8.T, J10.1, R9.1, R10.1, R11.2
unnamed: D1.1, R7.1
unnamed: D2.1, R8.1
unnamed: J1.2, U1.1
