Tuetuopay/dalton-evse/averell4evse/averell4evse.kicad_pcb

## KiCad design averell4evse/averell4evse.kicad_pcb (2022-01-18)

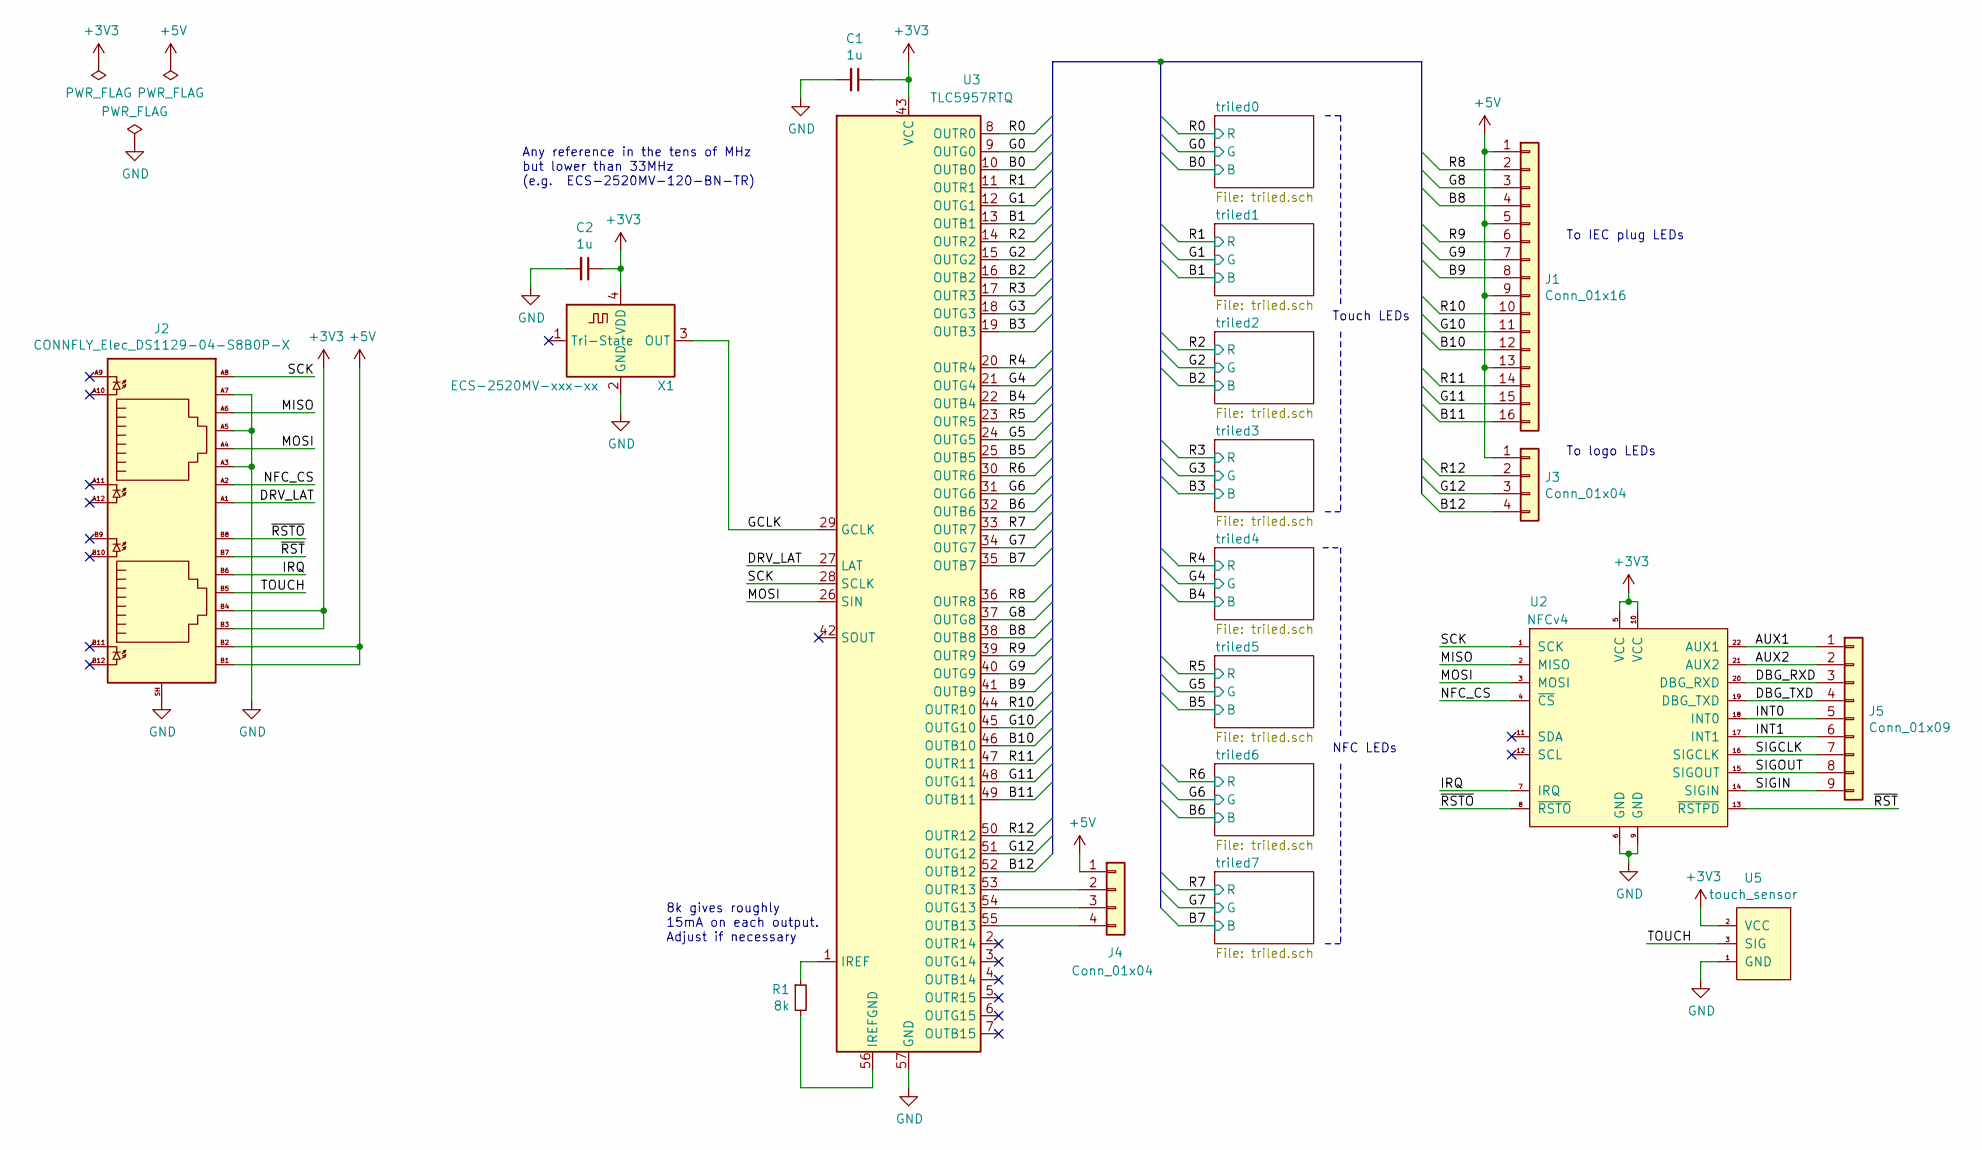
[picture p26: schematic averell4evse.sch]

Parts:
C1, C2: 1u; C_0603_1608Metric
J1: Conn_01x16; PinHeader_1x16_P2.54mm_Horizontal
J2: CONNFLY_Elec_DS1129-04-S8B0P-X
J3, J4: Conn_01x04; PinHeader_1x04_P2.54mm_Horizontal
J5: Conn_01x09; PinHeader_1x09_P2.54mm_Horizontal
R1: 8k; R_0603_1608Metric
U2: NFCv4; nfc_v4_mirror
U3: TLC5957RTQ; QFN-56-1EP_8x8mm_P0.5mm_EP5.6x5.6mm_ThermalVias
U5: touch_sensor
X1: ECS-2520MV-xxx-xx; Oscillator_SMD_ECS_2520MV-xxx-xx-4Pin_2.5x2.0mm

Connections:
+3V3: C1.1, C2.1, J2.B3, J2.B4, U2.5 (VCC), U2.10 (VCC), U3.43 (VCC), U5.2 (VCC), X1.4 (VDD)
+5V: J1.1, J1.5, J1.9, J1.13, J2.B1, J2.B2, J3.1, J4.1; also elsewhere on the board
/AUX1: J5.1, U2.22 (AUX1)
/AUX2: J5.2, U2.21 (AUX2)
/B0: U3.10 (OUTB0); also elsewhere on the board
/B1: U3.13 (OUTB1); also elsewhere on the board
/B2: U3.16 (OUTB2); also elsewhere on the board
/B3: U3.19 (OUTB3); also elsewhere on the board
/B4: U3.22 (OUTB4); also elsewhere on the board
/B5: U3.25 (OUTB5); also elsewhere on the board
/B6: U3.32 (OUTB6); also elsewhere on the board
/B7: U3.35 (OUTB7); also elsewhere on the board
/B8: J1.4, U3.38 (OUTB8)
/B9: J1.8, U3.41 (OUTB9)
/B10: J1.12, U3.46 (OUTB10)
/B11: J1.16, U3.49 (OUTB11)
/B12: J3.4, U3.52 (OUTB12)
/DBG_RXD: J5.3, U2.20 (DBG_RXD)
/DBG_TXD: J5.4, U2.19 (DBG_TXD)
/DRV_LAT: J2.A1, U3.27 (LAT)
/G0: U3.9 (OUTG0); also elsewhere on the board
/G1: U3.12 (OUTG1); also elsewhere on the board
/G2: U3.15 (OUTG2); also elsewhere on the board
/G3: U3.18 (OUTG3); also elsewhere on the board
/G4: U3.21 (OUTG4); also elsewhere on the board
/G5: U3.24 (OUTG5); also elsewhere on the board
/G6: U3.31 (OUTG6); also elsewhere on the board
/G7: U3.34 (OUTG7); also elsewhere on the board
/G8: J1.3, U3.37 (OUTG8)
/G9: J1.7, U3.40 (OUTG9)
/G10: J1.11, U3.45 (OUTG10)
/G11: J1.15, U3.48 (OUTG11)
/G12: J3.3, U3.51 (OUTG12)
/GCLK: U3.29 (GCLK), X1.3 (OUT)
/INT0: J5.5, U2.18 (INT0)
/INT1: J5.6, U2.17 (INT1)
/IRQ: J2.B6, U2.7 (IRQ)
/MISO: J2.A6, U2.2 (MISO)
/MOSI: J2.A4, U2.3 (MOSI), U3.26 (SIN)
/NFC_CS: J2.A2, U2.4 (~CS)
/R0: U3.8 (OUTR0); also elsewhere on the board
/R1: U3.11 (OUTR1); also elsewhere on the board
/R2: U3.14 (OUTR2); also elsewhere on the board
/R3: U3.17 (OUTR3); also elsewhere on the board
/R4: U3.20 (OUTR4); also elsewhere on the board
/R5: U3.23 (OUTR5); also elsewhere on the board
/R6: U3.30 (OUTR6); also elsewhere on the board
/R7: U3.33 (OUTR7); also elsewhere on the board
/R8: J1.2, U3.36 (OUTR8)
/R9: J1.6, U3.39 (OUTR9)
/R10: J1.10, U3.44 (OUTR10)
/R11: J1.14, U3.47 (OUTR11)
/R12: J3.2, U3.50 (OUTR12)
/SCK: J2.A8, U2.1 (SCK), U3.28 (SCLK)
/SIGCLK: J5.7, U2.16 (SIGCLK)
/SIGIN: J5.9, U2.14 (SIGIN)
/SIGOUT: J5.8, U2.15 (SIGOUT)
/TOUCH: J2.B5, U5.3 (SIG)
/~RST: J2.B7, U2.13 (~RSTPD)
/~RSTO: J2.B8, U2.8 (~RSTO)
GND: C1.2, C2.2, J2.A3, J2.A5, J2.A7, J2.SH, U2.6 (GND), U2.9 (GND), U3.57 (GND), U5.1 (GND), X1.2 (GND)
unnamed: J4.2, U3.53 (OUTR13)
unnamed: J4.3, U3.54 (OUTG13)
unnamed: J4.4, U3.55 (OUTB13)
unnamed: R1.1, U3.1 (IREF)
unnamed: R1.2, U3.56 (IREFGND)

Notes on the sheet:
8k gives roughly 15mA on each output. Adjust if necessary
NFC LEDs
Any reference in the tens of MHz but lower than 33MHz (e.g. ECS-2520MV-120-BN-TR)
To IEC plug LEDs
To logo LEDs
Touch LEDs

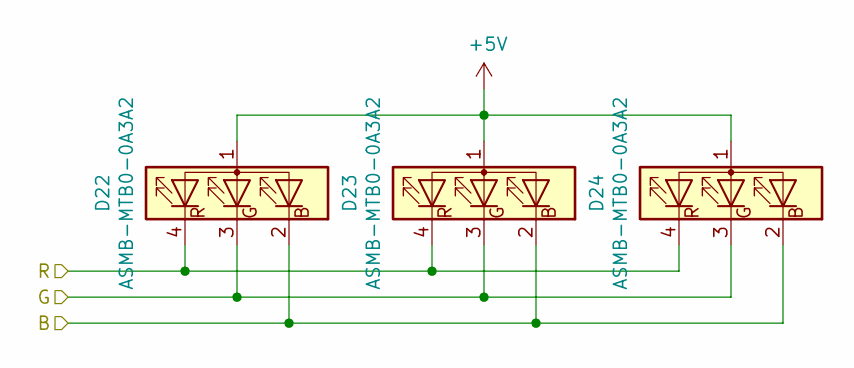
[picture p27: schematic triled.sch]

Parts:
D4, D5, D6: ASMB-MTB0-0A3A2; LED_Avago_PLCC4_3.2x2.8mm_CW

Connections:
+5V: D4.1 (A), D5.1 (A), D6.1 (A); also elsewhere on the board
/B0: D4.2 (BK), D5.2 (BK), D6.2 (BK); also elsewhere on the board
/G0: D4.3 (GK), D5.3 (GK), D6.3 (GK); also elsewhere on the board
/R0: D4.4 (RK), D5.4 (RK), D6.4 (RK); also elsewhere on the board

Parts of its further copies:
D1, D2, D3, D7, D8, D9, D10, D11, D12, D13, D14, D15, D16, D17, D18, D19, D20, D21, D22, D23, D24: ASMB-MTB0-0A3A2; LED_Avago_PLCC4_3.2x2.8mm_CW

Connections of its further copies:
+5V: D1.1 (A), D2.1 (A), D3.1 (A), D7.1 (A), D8.1 (A), D9.1 (A), D10.1 (A), D11.1 (A), D12.1 (A), D13.1 (A), D14.1 (A), D15.1 (A), D16.1 (A), D17.1 (A), D18.1 (A), D19.1 (A), D20.1 (A), D21.1 (A), D22.1 (A), D23.1 (A), D24.1 (A); also elsewhere on the board
/B1: D1.2 (BK), D2.2 (BK), D3.2 (BK); also elsewhere on the board
/B2: D7.2 (BK), D8.2 (BK), D9.2 (BK); also elsewhere on the board
/B3: D10.2 (BK), D11.2 (BK), D12.2 (BK); also elsewhere on the board
/B4: D16.2 (BK), D17.2 (BK), D18.2 (BK); also elsewhere on the board
/B5: D13.2 (BK), D14.2 (BK), D15.2 (BK); also elsewhere on the board
/B6: D19.2 (BK), D20.2 (BK), D21.2 (BK); also elsewhere on the board
/B7: D22.2 (BK), D23.2 (BK), D24.2 (BK); also elsewhere on the board
/G1: D1.3 (GK), D2.3 (GK), D3.3 (GK); also elsewhere on the board
/G2: D7.3 (GK), D8.3 (GK), D9.3 (GK); also elsewhere on the board
/G3: D10.3 (GK), D11.3 (GK), D12.3 (GK); also elsewhere on the board
/G4: D16.3 (GK), D17.3 (GK), D18.3 (GK); also elsewhere on the board
/G5: D13.3 (GK), D14.3 (GK), D15.3 (GK); also elsewhere on the board
/G6: D19.3 (GK), D20.3 (GK), D21.3 (GK); also elsewhere on the board
/G7: D22.3 (GK), D23.3 (GK), D24.3 (GK); also elsewhere on the board
/R1: D1.4 (RK), D2.4 (RK), D3.4 (RK); also elsewhere on the board
/R2: D7.4 (RK), D8.4 (RK), D9.4 (RK); also elsewhere on the board
/R3: D10.4 (RK), D11.4 (RK), D12.4 (RK); also elsewhere on the board
/R4: D16.4 (RK), D17.4 (RK), D18.4 (RK); also elsewhere on the board
/R5: D13.4 (RK), D14.4 (RK), D15.4 (RK); also elsewhere on the board
/R6: D19.4 (RK), D20.4 (RK), D21.4 (RK); also elsewhere on the board
/R7: D22.4 (RK), D23.4 (RK), D24.4 (RK); also elsewhere on the board

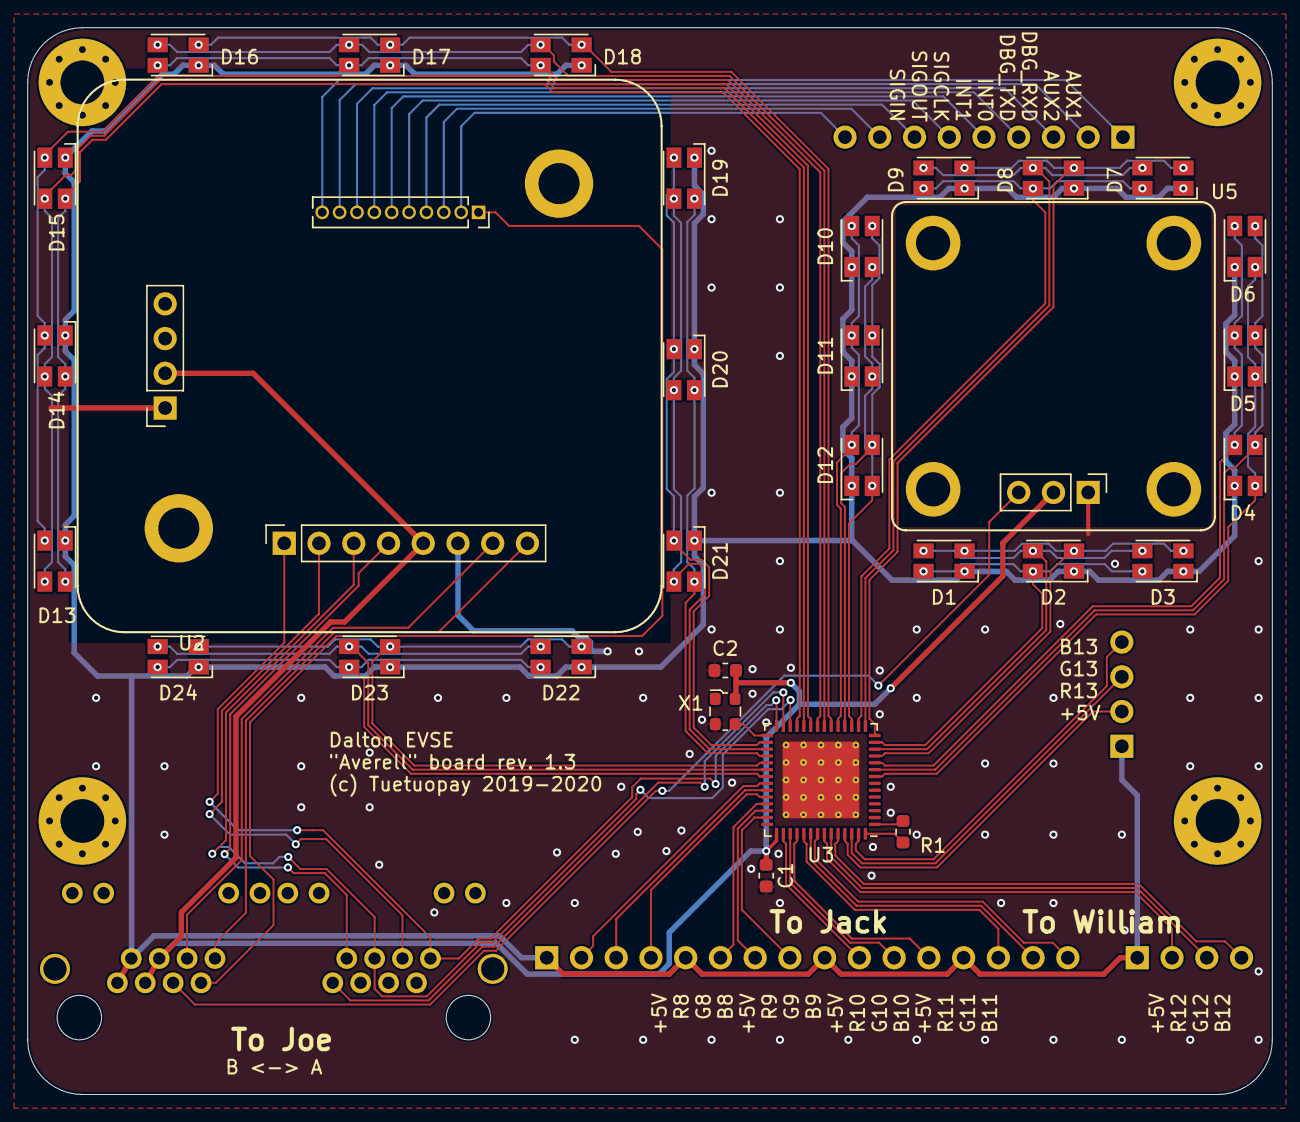
[picture p28: board averell4evse.kicad_pcb from above]

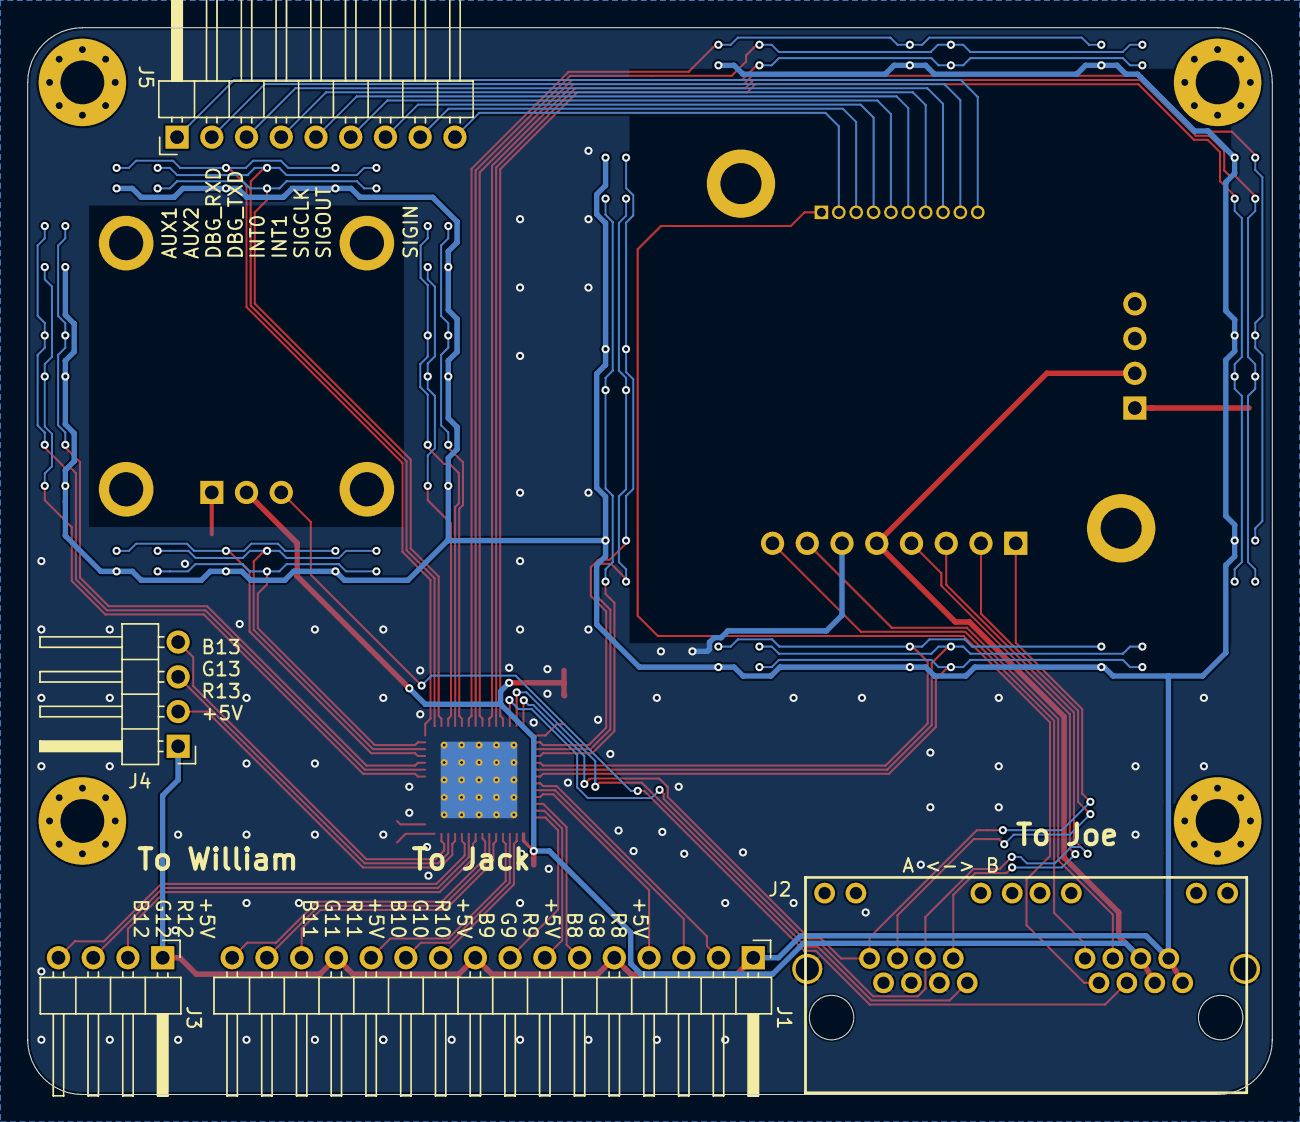
[picture p29: board averell4evse.kicad_pcb from below]

Board: 2 copper layers, 91.0 x 78.0 mm, 36 parts (5 on the bottom side), 66 nets.
