Tuetuopay/dalton-evse/(commit log)

2022-01-18 ma/footprint: Add FiPy footprint
2022-01-18 joe: Initial commit
    [joe4evse.kicad_pcb, joe4evse.sch]
2022-01-18 averell: Initial commit
    [averell4evse.kicad_pcb, averell4evse.sch]
2022-01-18 ma/fp: Add NFC v4 footprint
2022-01-18 ma/fp: Nicer looking NFCv4 footprint
2022-01-18 ma/fp: Add touch sensor module footprint
2022-01-18 averell/sch: First revision of the schematic done
    [averell4evse.sch]
2022-01-18 averell/sch: Annotate schematic
    [averell4evse.sch]
2022-01-18 averell/sch: Assign PCB footprints
    [averell4evse.sch]
2022-01-18 averell/sch: Swap LEDs text
    [averell4evse.sch]
2022-01-18 averell/pcb: First draft, dimensions and placement done
    [averell4evse.kicad_pcb]
2022-01-18 averell/sch: Swap test pad footprints from pad to plated hole
    [averell4evse.sch]
2022-01-18 averell/pcb: Routing done
    [averell4evse.kicad_pcb]
2022-01-18 ma/fp: Add PLCC4 LED footprint with 3D model
    [ASMB-MTB0-0A3A2.step]
2022-01-18 averell/*: Update LED footprint with custom internal one
    [averell4evse.kicad_pcb, averell4evse.sch]
2022-01-18 averell/pcb: Fix LTC5957 exposed pad connection to ground plane
    [averell4evse.kicad_pcb]
2022-01-18 averell/pcb: Add keepout zone under the NFC module
    [averell4evse.kicad_pcb]
2022-01-18 ma/fp: Add mirrored NFCv4 when mounted components facing down
2022-01-18 averell/sch: Use mirrored NFCv4 footprint
    [averell4evse.sch]
2022-01-18 averell/pcb: Re-route with mirror NFCv4 module
    [averell4evse.kicad_pcb]
2022-01-18 ma/fp/nfc_v4: Add 3D model
    [nfc_v4.FCStd, nfc_v4.step]
2022-01-18 averell/pcb: Add conn + copyright to silkscreen
    [averell4evse.kicad_pcb]
2022-01-18 averell/pcb: Add Enexten logo to silkscreen
    [averell4evse.kicad_pcb]
2022-01-18 averell/pcb: Add measurements to Dwgs.User layer
    [averell4evse.kicad_pcb]
2022-01-18 averell/sch: Put 3 LEDs per channel rather than one
    [averell4evse.sch, triled.sch]
2022-01-18 averell/sch: Add power flags to make ERC happy
    [averell4evse.sch, triled.sch]
2022-01-18 averell/pcb: Re-route LEDs with three per side
    [averell4evse.kicad_pcb]
2022-01-18 jack: Initial commit
    [jack4evse.kicad_pcb, jack4evse.sch]
2022-01-18 ma/fp: Add male 2x8 1.27mm pin headers
    [FTSH-108-01-F-D-RA.stp]
2022-01-18 ma/fp: Add 2x8 1.27mm female pin socket
    [CLP-108-02-F-DH.stp]
2022-01-18 jack/*: Add schematic and basic board layout
    [jack.FCStd, jack.dxf, jack4evse.kicad_pcb, jack4evse.sch]
2022-01-18 jack/pcb: Done routing
    [jack4evse.kicad_pcb]
2022-01-18 jack: Add square notch to board outline for main headers
    [jack.FCStd, jack.dxf]
2022-01-18 jack/sch: Switch main headers to 1x16
    [jack4evse.sch]
2022-01-18 jack: Re-route board with new connector and new board outline
    [jack4evse.kicad_pcb]
2022-01-18 jack: Change LED footprint to ma ones
    [jack4evse.kicad_pcb, jack4evse.sch]
2022-01-18 averell: Replace test pads with 0.1" pin headers
    [averell4evse.kicad_pcb, averell4evse.sch, triled.sch]
2022-01-18 averell/pcb: Fix some silkscreen labels placement
    [averell4evse.kicad_pcb]
2022-01-18 averell/pcb: Add ground plane keepout under the touch sensor
    [averell4evse.kicad_pcb]
2022-01-18 jack/pcb: Add enexten logo + rev info to silkscreen
    [jack4evse.kicad_pcb]
2022-01-18 joe: Add FIPY Pinout
    [FIPYPinout.ods]
2022-01-18 joe: Add enexten-devkit schematic in joe
    [fipy.sch, joe4evse.sch]
2022-01-18 averell/*: Make a real CS for LED driver
    [averell4evse.kicad_pcb, averell4evse.sch, triled.sch]
2022-01-18 averell/pcb: Add DRV_CS to Joe connector silkscreen
    [averell4evse.kicad_pcb]
2022-01-18 ma: Add single and dual RJ45 connectors
2022-01-18 averell/sch: Change Joe connector to RJ45
    [averell4evse.sch]
2022-01-18 averell/pcb: Replace Joe connector with RJ45 jacks
    [averell4evse.kicad_pcb, averell4evse.sch]
2022-01-18 william: Initial commit
    [william4evse.kicad_pcb, william4evse.sch]
2022-01-18 ma/{sym, fp}: Add RCMB121 module
    [RCMB121.step]
2022-01-18 ma/sym: Set RCMB121 footprint
2022-01-18 william: First version
    [RCMB121.FCStd, RCMB121.dxf, william4evse.kicad_pcb, william4evse.sch]
2022-01-18 william/pcb: Add dimensions to Dwgs.User layer
    [william4evse.kicad_pcb]
2022-01-18 averell/pcb: Move RJ45 connector and mounting screws backwards
    [averell4evse.kicad_pcb]
2022-01-18 ma/*: Add symbols and footprints for Joe
    [JS202011CQN.stp]
2022-01-18 joe/sch: Schematic should be done
    [evse.sch, fipy.sch, joe4evse.sch, relay.sch]
2022-01-18 joe/sch: Assign footprints to components
    [evse.sch, fipy.sch, joe4evse.sch, relay.sch]
2022-01-18 ma/sym: Add DPDT switch and 1N4001 SMD equivalent
2022-01-18 joe/sch: Remove relays and only keep control circuitry
    [evse.sch, fipy.sch, joe4evse.sch, relay.sch]
2022-01-18 joe/sch: Add mounting holes
    [joe4evse.sch]
2022-01-18 joe/pcb: Placement should be done
    [joe4evse.kicad_pcb]
2022-01-18 joe/sch: Remove relays and reference AC test to neutral rather than GND
    [evse.sch, joe4evse.sch]
2022-01-18 joe/pcb: Routing done
    [joe4evse.kicad_pcb]
2022-01-18 joe/{sch, pcb}: Add missing temp sensor
    [joe4evse.kicad_pcb, joe4evse.sch]
2022-01-18 joe: Add temperature sensor
    [joe4evse.kicad_pcb, joe4evse.sch]
2022-01-18 WIP: joe: Add errout signal
    [fipy.sch, joe4evse.sch]
2022-01-18 joe/*: Add 0.1" header for easy access to RJ45 signals
    [fipy.sch, joe4evse.kicad_pcb, joe4evse.sch]
2022-01-18 joe/pcb: Misc silk fixes
    [joe4evse.kicad_pcb, joe4evse.sch]
2022-01-18 joe: Add 12V ERROUT
    [fipy.sch, joe4evse.kicad_pcb, joe4evse.sch]
2022-01-18 ma/3d: Add 2520 crystal oscillator
    [2520 SMD Crystal Oscillator.STEP]
2022-01-18 averell/pcb: Add silk with RJ45 numbering
    [averell4evse.kicad_pcb]
2022-01-18 averell/pcb: Set xtal 3D model
    [averell4evse.kicad_pcb]
2022-01-18 averell{sch, pcb}: Change oscillator and fix improper traces
    [averell4evse.kicad_pcb, averell4evse.sch]
2022-01-18 joe/*: Connect charge pump boost pin to +12V
    This increases the switching frequency from 10kHz to 45kHz, making the
    pump capacitor resonating inaudible.
    [evse.sch, joe4evse.kicad_pcb]
2022-01-18 joe/*: Rename LED_CS signal to LED_LAT
    [fipy.sch, joe4evse.kicad_pcb, joe4evse.sch]
2022-01-18 joe/pcb: Rev 1.1
    [joe4evse.kicad_pcb]
2022-01-18 averell/*: Remove LED driver CS thingy
    [averell4evse.kicad_pcb, averell4evse.sch, triled.sch]
2022-01-18 billy: Initial commit
    [billy4evse.kicad_pcb, billy4evse.sch]
2022-01-18 ma/fp: Add audio jack footprint
2022-01-18 ma/3d: Add 2 position 5mm screw terminal
    [ScrewTerminal.STEP]
2022-01-18 billy/*: First billy draft
    [billy4evse.kicad_pcb, billy4evse.sch]
2022-01-18 ma/{fp, 3d}: Add audio jack 3D model
    [PJ-307C.FCStd, PJ-307C.step]
2022-01-18 ma/{fp, 3d}: Add BC-53 DIN case
    [pxc_2896403_03_BC-53-6-UT-HBUS-BK_3D.stp, pxc_2896416_01_BC-53-6-OT-U11-KMGY_3D.stp]
2022-01-18 ma/{fp, 3d}: Add vertical audio jack
    [JIS C 6560.FCStd, JIS C 6560.step]
2022-01-18 billy{sch, pcb}: DIN-compatible second draft
    [billy4evse.kicad_pcb, billy4evse.sch]
2022-01-18 ma/3d: Add HLK-PM0x
    [HLK-PM0x.FCStd, HLK-PM0x.step]
2022-01-18 billy/pcb: Set HLK-PM01 3D model
    [billy4evse.kicad_pcb]
2022-01-18 ma/3d: Remove sample PCB from BC-53 cover model
    [pxc_2896416_01_BC-53-6-OT-U11-KMGY_3D.stp]
2022-01-18 ma/3d: Add FiPY/LoPy 3D model
    [LoPy v1.stp]
2022-01-18 billy{sch, pcb}: Add GPIO headers
    [billy4evse.kicad_pcb, billy4evse.sch]
2022-01-18 ma/3d: Add 3.5mm screw terminal model
    [Screw Terminal Block 3.5mm 2-way.step]
2022-01-18 billy{sch, pcb}: Add screw terminals on top for current sensors
    [billy4evse.kicad_pcb, billy4evse.sch]
2022-01-18 billy: Add clamping diodes to sensor inputs
    [billy4evse.kicad_pcb, billy4evse.sch]
2022-01-18 ma/3d: Add Würth 614105150721 Vertical USB µB
    [Wurth_614105150721.step]
2022-01-18 billy: Switch USB connector for vertical connector
    [billy4evse.kicad_pcb, billy4evse.sch]
2022-01-18 billy: Fix some DRC issues
    [billy4evse.kicad_pcb]
2022-01-18 billy/sch: List all LCSC P/N
    [billy4evse.sch]
2022-01-18 billy{sch, pcb}: Finish LCSC P/N list and fix bottom-left PCB notch
    [billy4evse.kicad_pcb, billy4evse.sch]
2022-01-18 jack/{sch, pcb}: Make one single ring pcb with all leds
    [jack.FCStd, jack.dxf, jack4evse.kicad_pcb, jack4evse.sch]
2022-01-18 ma/fp: Fix RCMB121 pin positions
2022-01-18 william/pcb: Update with fixed RCMB footprint
    [william4evse.kicad_pcb]
2022-01-18 william: Rev. 1.1
    [william4evse.kicad_pcb]
2022-01-18 william: Add err_out relay output
    [william4evse.kicad_pcb, william4evse.sch]
2022-01-18 joe/{sch, pcb}: Swap some MCU pins for easier pinout
    - Swap P23/P13
    - Swap P21/P16
    [fipy.sch, joe4evse.kicad_pcb]
2022-01-18 joe/lib: Misc KiCAD stuff
2022-01-18 joe/pcb: Fix D13 footprint
    [evse.sch, joe4evse.kicad_pcb]
2022-01-18 joe/{sch, pcb}: Combine AC_RELAY and RCMB output
    [joe4evse.kicad_pcb, joe4evse.sch]
2022-01-18 joe/{sch, pcb}: Remove input shottky diodes
    [fipy.sch, joe4evse.kicad_pcb, joe4evse.sch]
2022-01-18 joe/pcb: Rev 1.2
    [joe4evse.kicad_pcb]
2022-01-18 joe/{sch, pcb}: Add 0r resistors in parallel of SW1 for prod boards
    [evse.sch, fipy.sch, joe4evse.kicad_pcb, joe4evse.sch]
2022-01-18 joe/pcb: Rev v1.3
    [joe4evse.kicad_pcb]
2022-01-18 william: Revert "Add err_out relay output"
    This reverts commit fe4c97044222ea82c6b882aa488b85d2dc32cb0e.
    [william4evse.kicad_pcb, william4evse.sch]
2022-01-18 ma/fp: Fix RCMB hole size
    [RCMB121.step]
2022-01-18 ma/*: Fix line endings and file permissions
    Screw you, windows...
    [ASMB-MTB0-0A3A2.step, CLP-108-02-F-DH.stp, FTSH-108-01-F-D-RA.stp, HLK-PM0x.FCStd, HLK-PM0x.step, JIS C 6560.FCStd, JIS C 6560.step, JS202011CQN.stp]
2022-01-18 william: Misc updates
    - Add power inductor in the power line
    - Swap TEST_IN and X30_OUT signals
    - Fix board outline to take RCMB bumps into account
    - Fix RCMB hole size
    [RCMB121.FCStd, william4evse.kicad_pcb, william4evse.sch]
2022-01-18 william{sch, pcb}: Swap (again) wires
    [william4evse.kicad_pcb, william4evse.sch]
2022-01-18 william: Release v1.2
    [william4evse.kicad_pcb]
2022-01-18 william/pcb: Fix missing 5V trace
    [william4evse.kicad_pcb]
2022-01-18 william: Release v1.3
    [william4evse.kicad_pcb]
